Norman-w/SlidingRailHook/output/fit-12mm-v2/delivery/README.md

# 新挂钩 + 复用旧挂钩的兼容轨道

本目录只有这两类打印件，**不包含给新挂钩另打一条 12 mm 轨道**。3MF 均为原生已切片项目，X1 Carbon / 0.4 mm / PETG，未发送打印任务。

## 正式文件

| 文件 | 用途 | 切片估算（含支撑） |
| --- | --- | --- |
| `hook-H12x6-v2-12pcs-PETG-X1C-0p4-0p12.3mf` | 一板 12 个新挂钩，槽净高 12.6 mm，配你现有轨道 | 20.2 g，2 小时 53 分 38 秒；支撑约 2.86 g |
| `legacy-8mm-rail-300-PETG-X1C-0p4-0p20.3mf` | 300 mm 兼容轨道，用来复用之前打印的旧挂钩 | 11.49 g，58 分 31 秒；支撑约 2.61 g |

## 建议先打印试配件

- `hook-H12x6-v2-1pcs-PETG-X1C-0p4-0p12.3mf`：一个新挂钩，试你现有轨道；约 1.99 g / 30 分 25 秒。
- `legacy-8mm-rail-50-PETG-X1C-0p4-0p20.3mf`：50 mm 兼容短轨，试旧挂钩；约 2.22 g / 20 分 54 秒。

确认能从端部装入、往复滑动且不脱轨，再打印正式整板/长轨。STL 也已提供，单位 mm，导入保持 100% 比例。

## 两组尺寸

| 尺寸 | 你现有轨道 / 新挂钩 | 旧挂钩用的兼容轨道 |
| --- | --- | --- |
| 靠墙翼缘高 | 12 mm | 12 mm |
| 靠人翼缘高 | 12 mm | 8 mm |
| 外宽 / 两翼内距 | 6 / 4 mm | 5.8 / 3.8 mm |
| 翼缘 / 腹板厚 | 1 / 1 mm | 1 / 1 mm |
| 挂钩槽净高 | 新版 12.6 mm | 旧版 8.6 mm |

旧挂钩原本只容纳 8 mm 前翼缘，不能装到现有 12 mm 前翼缘上。兼容轨道单独恢复这套尺寸，因此旧挂钩可继续使用。新挂钩只调整滑块配合包络，保留原钩身、R5/240°弯曲和根部圆角，不整体缩放；侧壁保留名义 1 mm。

## 朝向与清理

新挂钩沿用已打印的 v1 PETG 工艺：侧放、0.12 mm 层高、Snug 紧贴普通支撑、3 圈墙、12% Gyroid；没有更改或绕过喷嘴硬度检查。

兼容轨道使用 0.20 mm 层高，绕 X 转 90°侧立，再绕 Z 转 -45°斜放。300 mm 一体轨已通过切片器床面/禁区检查，没有缩放。功能翼缘面竖直打印，悬空窄边下方有实际支撑；清理该窄边、Brim 和毛刺后试装。斜放投影约 216 mm，不表示轨道长度变短。

温度沿用通用 PETG：255°C 喷嘴、65°C Textured PEI。请按实际料卷与板型核对。安装仍需可靠固定和端部防滑脱，未做实际承载试验。

## 验证与边界

已核对新槽 12.6 mm、旧槽 8.6 mm，新参考截面外 6 / 内 4 mm、旧兼容截面外 5.8 / 内 3.8 mm；两组配合从端部进入到整段滑动均无数字干涉。旧挂钩装入 12 mm 翼缘的反例有约 26 mm³ 干涉，明确不能混用。新钩身平移后的形状差异体积小于 0.0001 mm³。

3MF 已通过 CLI 独立重开、封闭实体、数量、1:1 比例、床面与切片警告检查；实际支撑/接触层路径（含圆弧）也已抽样核对。未发现支撑接触新挂钩受保护滑槽/正面，或兼容轨道的翼缘 Z 向滑动平面。

本机图形切片器打开项目后，自动化窗口读取失败，**GUI 预览验收未完成**。请在你的 Bambu Studio 重开最终 3MF，核对机器、喷嘴、PETG、板型及预览。实物试配、表面、收缩、安装和承载仍待确认。

`manifest.json` 保存交付文件 SHA-256；上级 `fit-validation.json` 和各打印子目录 `plate-validation.json` 保存详细结果。内部 `stl/rail.stl` 是新实测轨道的计算参考，不属于本次打印清单。旧发布包、旧挂钩打印包均未覆盖。
