Norman-w/SlidingRailHook/docs/rail-fit-v2.md

# 实测 H 轨配合修正 v2

用户确认的实物截面：两片翼缘均高 12 mm，Z 向外尺寸 6 mm、翼缘内侧净距 4 mm，翼缘及中间腹板厚 1 mm。X 沿轨道、Y 向上、Z 离开柜门；挂钩从 X 端部滑入，C 形开口朝 -Z。材料/工艺沿用 PETG FDM、X1 Carbon 0.4 mm。

原 v1 错把靠人的翼缘设为高 8 mm，滑块 Y 向净空因此只有 8.6 mm，不能安装到 12 mm 高的翼缘上。这是截面理解错误，不是用整体缩放修正的打印收缩。

| 配合项 | 实测轨道 / 新挂钩 v2 | 回收旧挂钩用兼容轨道 |
| --- | --- | --- |
| 靠墙翼缘高 | 12 mm | 12 mm |
| 靠人翼缘高 | 12 mm | 8 mm |
| 外尺寸 / 两翼内距 | 6 / 4 mm | 5.8 / 3.8 mm |
| 翼缘 / 腹板厚 | 1 / 1 mm | 1 / 1 mm |
| 挂钩滑槽 Y 净高 | 12.6 mm | 旧挂钩为 8.6 mm |
| 单侧名义 Y 间隙 | 0.3 mm | 0.3 mm |

新挂钩保持 X 向 18 mm、钩身 9→4.5 mm 锥度、厚 3 mm、R5/240°弯曲及原根部补胶；只按新配合包络派生滑块与钩根位置。滑块侧壁按 1 mm 保留，不挤占 12.6 mm 净空。受力路径仍为钩身 → 连续根部/圆角 → 滑块上下捕获边 → 轨道前翼缘 → 腹板 → 柜门安装面。

`src/rail_legacy_8mm.scad` 是为旧挂钩单独生成的新兼容轨道入口；原 v0.1.0 发布包和 print-12-v1 不覆盖。兼容轨道的 5.8/3.8 mm 为新导出精确尺寸，CSG 重叠只位于腹板端部，不增厚翼缘。

建议先用短轨和一个挂钩试配，确认能从端部装入、往复滑动且不脱轨，再打印长轨/整板。几何无干涉不代表实物首层、装配及长期承载已验收。
