Norman-w/SlidingRailHook/docs/releases/v0.1.0.md

# v0.1.0 — 根部四角连续补胶（FDM 原型）

- 修复挂钩与滑块交界处四个三面交汇角的缺口；保留四条 R1.25 凹圆角，以连续转角曲面连接。
- 保留 R5、240°、12 mm 直段、3 mm 厚度和 9/4.5 mm 渐缩宽度；弯钩仍朝 +Z 人侧。
- 提供一体式 `slider_hook.stl`，不再把重叠的滑块和钩子作为两个可单独装配的打印件。
- 四个打印 STL 均通过封闭拓扑、法线、单一实体和无退化三角面检查。四角分别验证与基座、钩子及相邻胶脚的正体积重叠；轨道 6 个位置的干涉体积均为 0。
- 附带 OpenSCAD 源码、可复现导出/验证脚本、带 XYZ 轴的等轴图、根部近景及 SHA-256 校验和。

下载 `SlidingRailHook-v0.1.0.zip` 获取源码与当前打印件，或分别下载四个 STL。

单位为 mm。轨道长 300 mm、截面高 12 mm、总深 5.8 mm；请先确认打印床尺寸。

**尚未验证：** 指定打印机/材料的切片、0.30 mm 间隙的实物试配、固定方式和承载寿命。此发布为原型，不包含打印任务或额定承载保证。
