Norman-w/SlidingRailHook/output/legacy-rail-upright-v3/delivery/README.md

# 旧挂钩兼容轨道 · 端面朝下竖打 v3 · STL

仅供已经打印的旧版 8.6 mm 槽挂钩复用。不是给新 12.6 mm 槽挂钩另造轨道。
截面与 v2 兼容轨道完全相同：靠墙翼缘高 12 mm、靠人翼缘高 8 mm、总厚 5.8 mm、内距 3.8 mm，翼缘与腹板均厚 1 mm。不做特殊拼接。

- `legacy-hooks-rail-front8-back12-L200-upright-v3.stl`：200 mm 常用版。
- `legacy-hooks-rail-front8-back12-L240-upright-v3.stl`：240 mm 加长版。

## 如何摆放

STL 已将长度转到打印机 Z 轴；以毫米、100% 比例导入，**不要再自动定向或放平**。包围盒应为 **12 × 5.8 × 200/240 mm**；顶视图能看到工字截面。装配坐标 X→打印 Z、装配 Y→打印 X、装配 Z→打印 Y，这是旋转，不是缩放。

本机已安装 X1 Carbon 0.4 mm 配置的 `printable_height` 为 **250 mm**。这两个版本分别留 50/10 mm 高度余量；不把 300 mm 长轨竖着放进去。

## 底部“加固圈”与支撑

竖打每层截面相同，没有需要承托的悬垂。实际 QA 切片保持自动支撑开启，检查 Support 与 Support interface 的挤出路径为零；这不等于细长件已经通过实物防倒测试。

底部在 Bambu Studio 里开启**外侧 Brim，宽 10 mm、物体间距 0.1 mm**，它是单层可拆黏附边，不是主体支撑。STL 本身不保存 Brim、材料、速度或层高。**没有把永久圆盘并入 STL**，否则会挡住挂钩从端部穿入或影响贴墙。拆边并去掉端面毛刺后再装入挂钩。

验证方案沿用 PETG / 0.4 mm，0.20 mm 层高；外墙 25、内墙 35、首层 20 mm/s，常规加速度 500 mm/s²，启用小层冷却减速。先打一条 200 mm，观察首层附着与上端晃动，再决定是否使用 240 mm。不要为了这次导入修改打印机真实喷嘴设置或绕过耗材校验。

没有支撑接触痕不等于镜面：仍有层纹、接缝、收缩或拉丝，先试配，不用整体缩放补偿。把竖向接缝尽量放在贴墙的非滑动面，保留功能面原尺寸。Brim 只能改善底部附着，不能保证消除高处摆动。长轨安装后应沿靠墙翼缘可靠固定，不把薄壁轨当成悬空承重梁。

## 多条安装

长度不够就多打印几条，分别贴装。若需要跨接缝滑动，两条轨道的前翼缘和端面必须对齐、去毛刺；普通端面对接并不是自定位接头，不保证挂钩跨缝完全无感。不要用厚胶堆在滑动面上。

300 mm 在床面内转 45°与向空中倾斜是两回事：前者只改变占地，不会凭空消除 H 型截面的悬垂；后者会产生新的下悬面。这次采用的不是这两种斜放，而是端面着床的竖打。

## 复现与验证边界

源入口：`src/rail_legacy_upright.scad`，参数 `segment_length=200/240`。
执行：`python src/scripts/build_upright_rail.py --slice-check`（依赖 requirements-print.txt、OpenSCAD 与本机 Bambu Studio）。
`manifest.json` 记录源与 STL 哈希、旋转矩阵、尺寸、拓扑、截面和旧挂钩装入路径；`../reports/` 记录本地实际切片检查。内部 QA 的 3MF 不作为本次打印文件交付。未发送打印任务；实物尺寸、层间强度、滑动手感与防倒仍待首件验证。

Brim 的宽度、间距和可移除性说明可核对 [Bambu Studio 官方源代码](https://github.com/bambulab/BambuStudio/blob/v01.10.02.76/src/libslic3r/PrintConfig.cpp)。
