Norman-w/SlidingRailHook/output/fit-12mm-v2/new-hooks-12/toolpaths-review.png

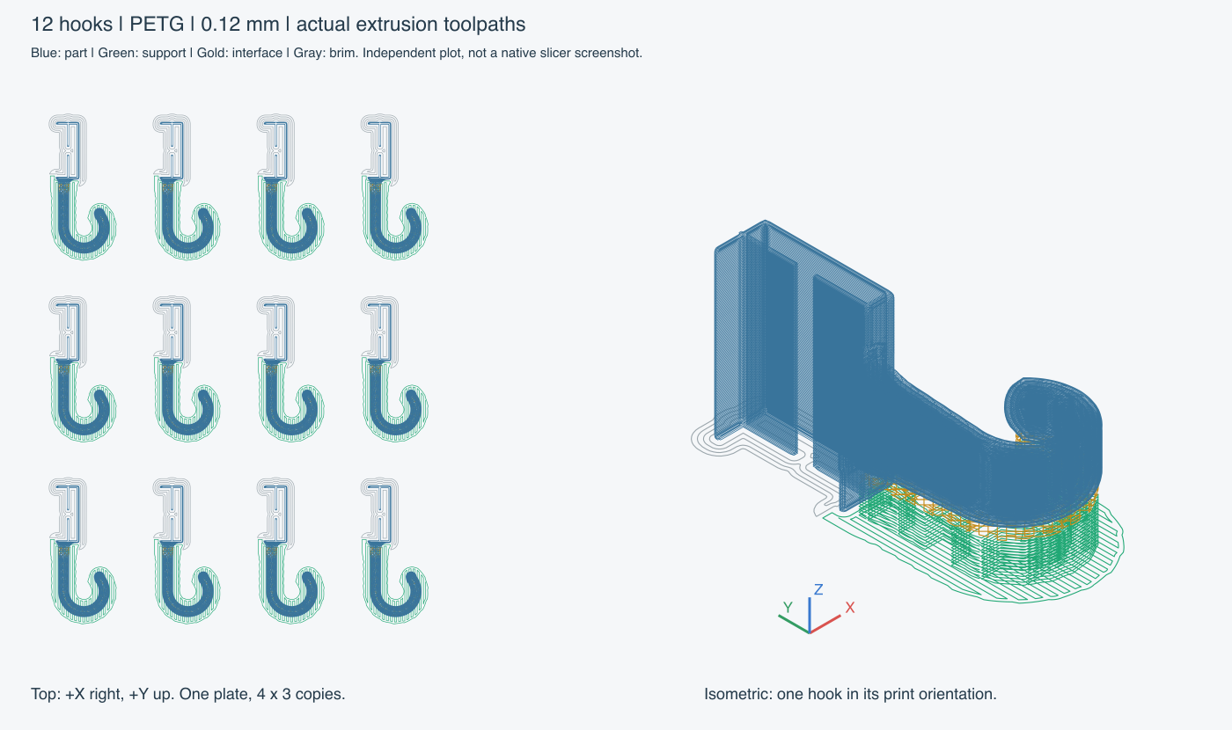
output/fit-12mm-v2/new-hooks-12/toolpaths-review.png
