Norman-w/SlidingRailHook/output/fit-12mm-v2/renders/new-fit-section.png

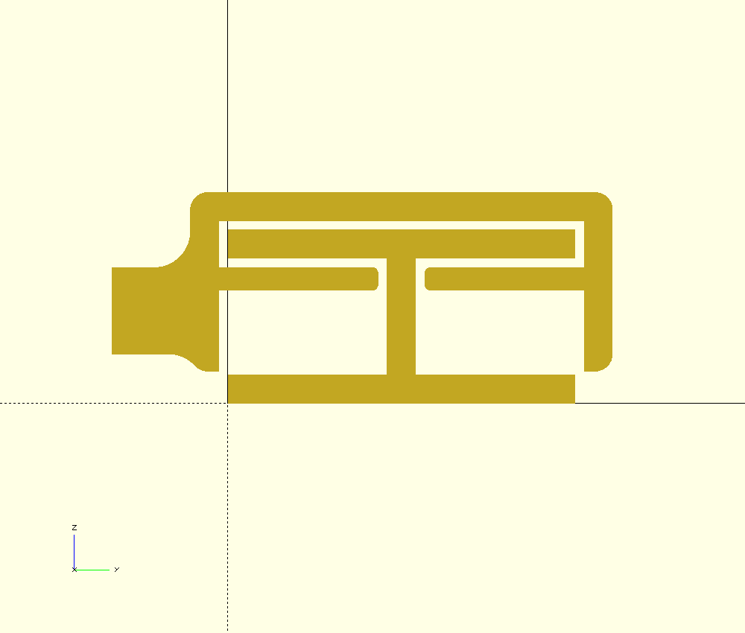
output/fit-12mm-v2/renders/new-fit-section.png
