Norman-w/SlidingRailHook/output/fit-12mm-v2/renders/new-hook-front.png

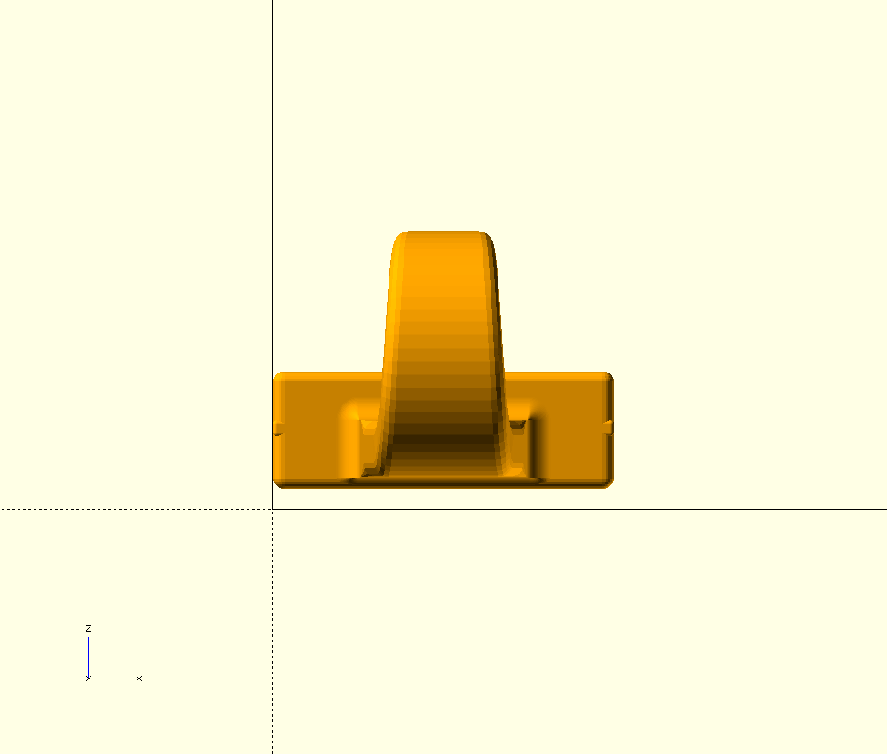
output/fit-12mm-v2/renders/new-hook-front.png
