Norman-w/SlidingRailHook/output/releases/v0.1.0/renders/root-isometric-axes.png

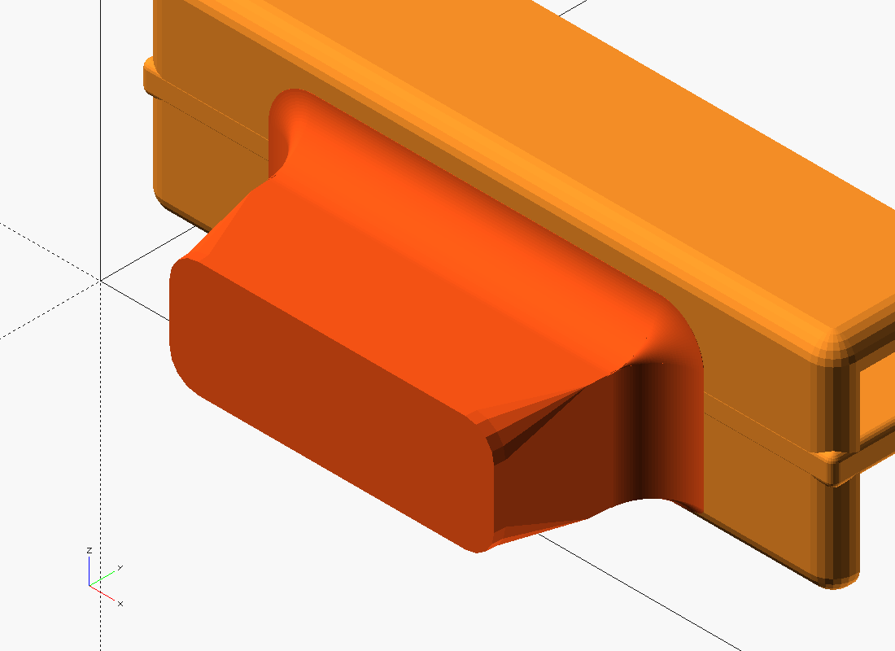
output/releases/v0.1.0/renders/root-isometric-axes.png
