Norman-w/SlidingRailHook/output/releases/v0.1.0/renders/root-underside-axes.png

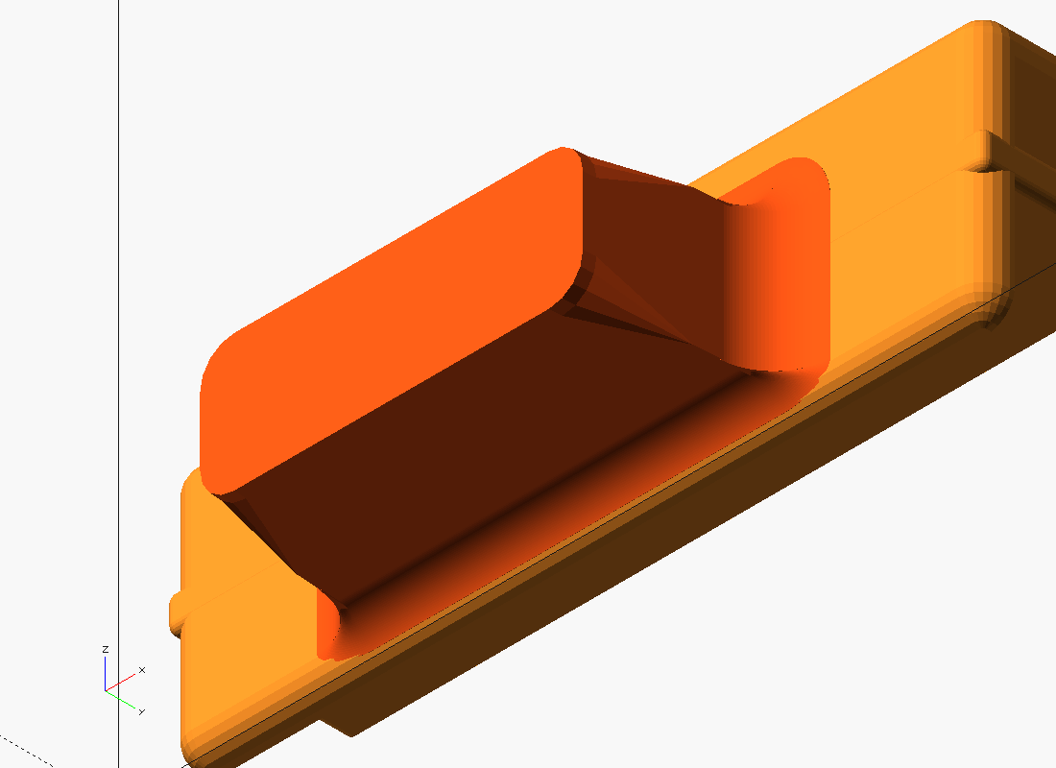
output/releases/v0.1.0/renders/root-underside-axes.png
