Norman-w/SlidingRailHook/output/renders/end-stop-iso.png

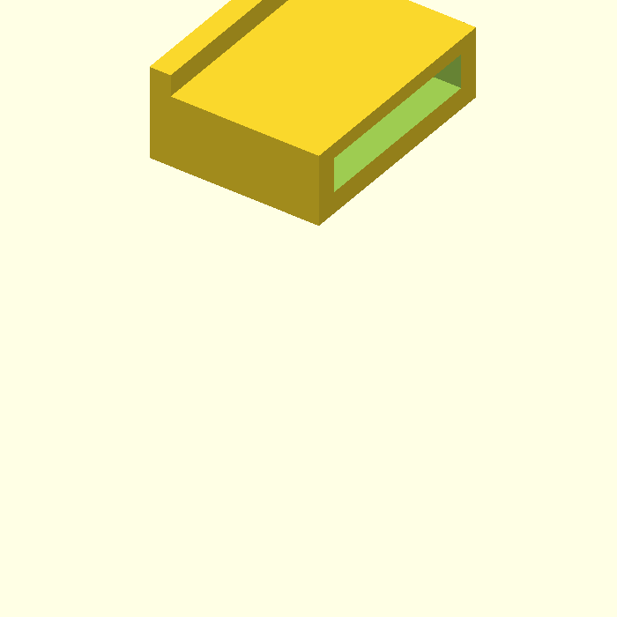
output/renders/end-stop-iso.png
