Norman-w/SlidingRailHook/output/renders/rail-cross-section.png

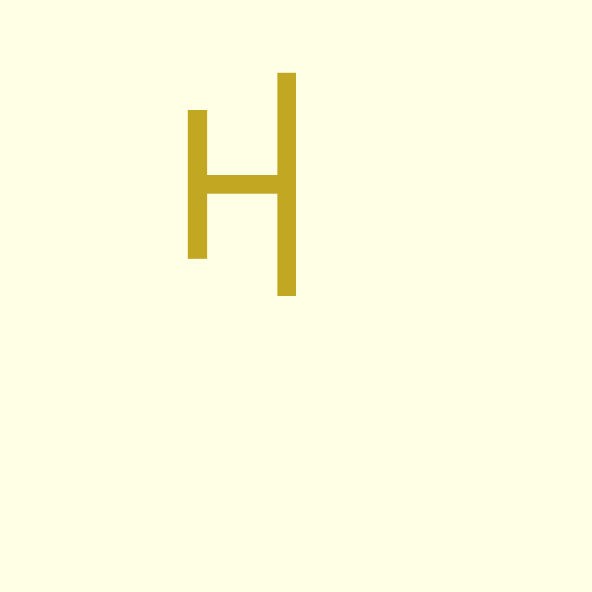
output/renders/rail-cross-section.png
