Norman-w/SlidingRailHook/output/renders/rail-front.png

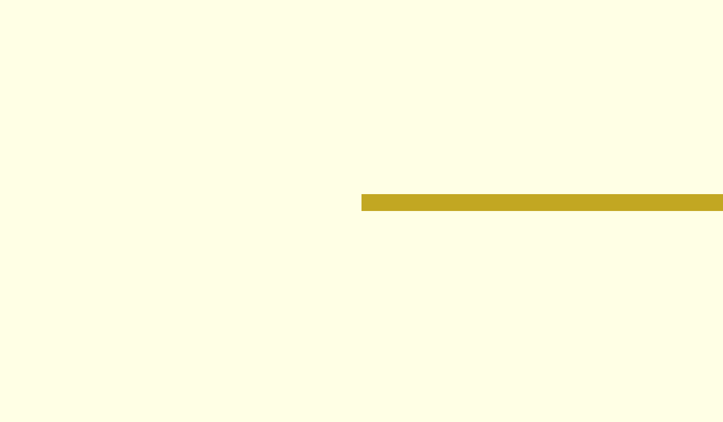
output/renders/rail-front.png
