Norman-w/SlidingRailHook/output/renders/rail-iso.png

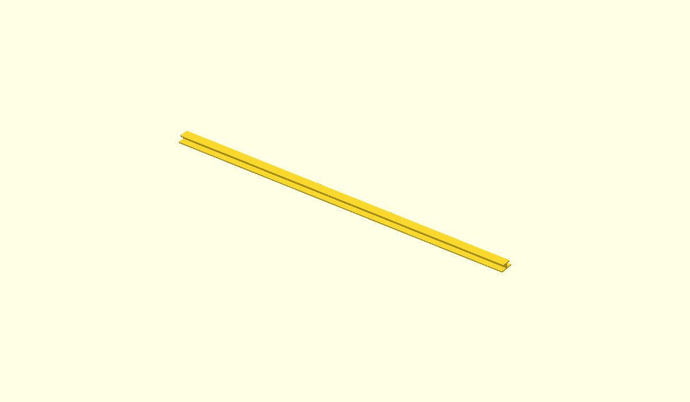
output/renders/rail-iso.png
