Norman-w/SlidingRailHook/output/renders/rail-top.png

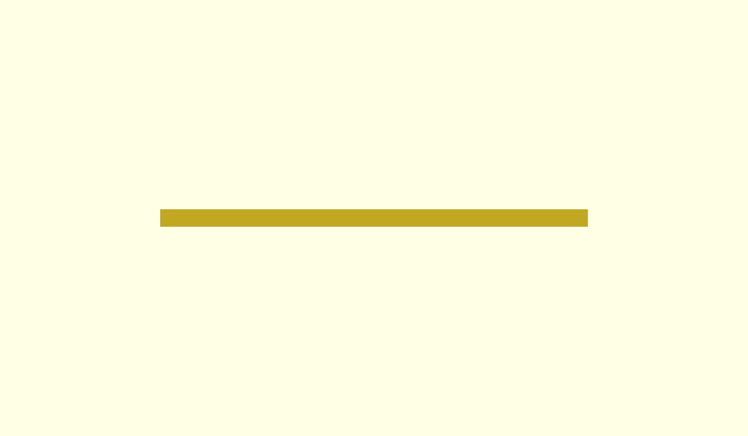
output/renders/rail-top.png
