Norman-w/SlidingRailHook/output/versions/root-side-fillets-v2-2026-10-18/after/renders/root-left-right-plan.png

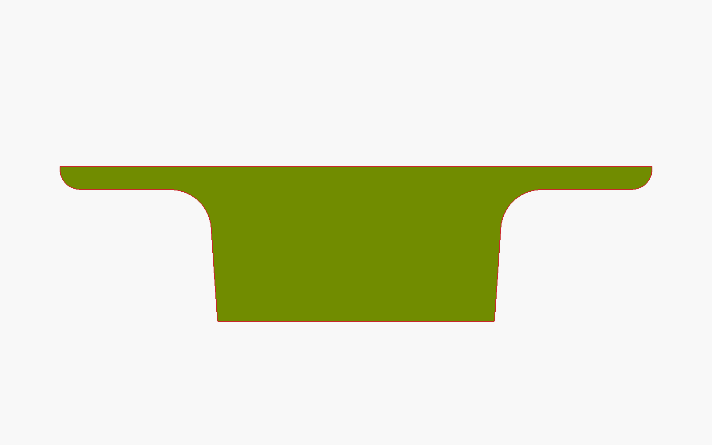
output/versions/root-side-fillets-v2-2026-10-18/after/renders/root-left-right-plan.png
