Norman-w/SlidingRailHook/output/versions/root-side-fillets-v2-2026-10-18/before/renders/hook-bent-side.png

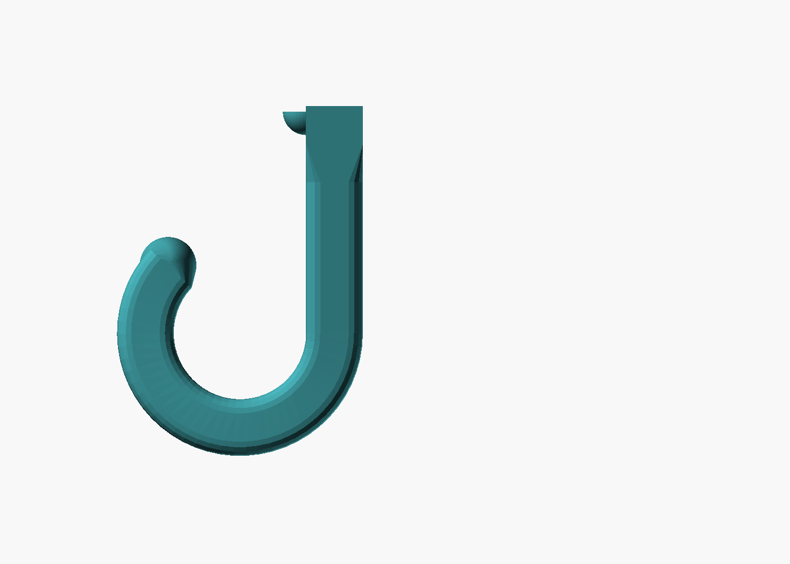
output/versions/root-side-fillets-v2-2026-10-18/before/renders/hook-bent-side.png
