Norman-w/SlidingRailHook/output/versions/root-yz-cove-v3-2026-10-18/after/renders/root-yz-section-axes.png

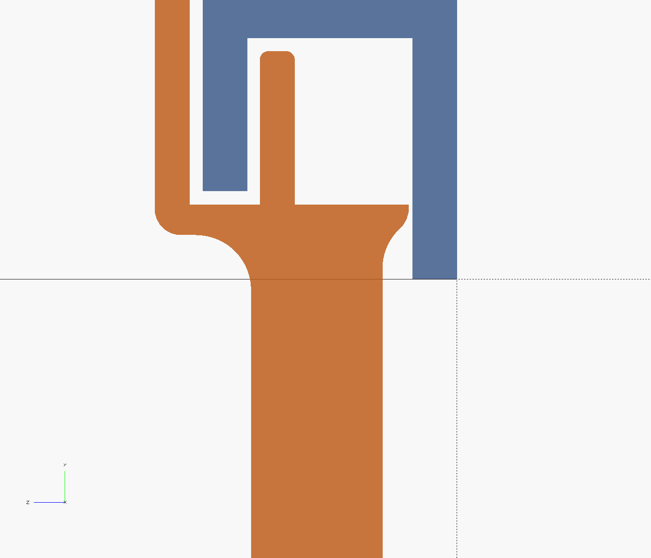
output/versions/root-yz-cove-v3-2026-10-18/after/renders/root-yz-section-axes.png
