Norman-w/SlidingRailHook/output/3d-print/history/hook_bent-240deg-rounded-0p75-endcap-pre-full-round-2026-10-18.stl

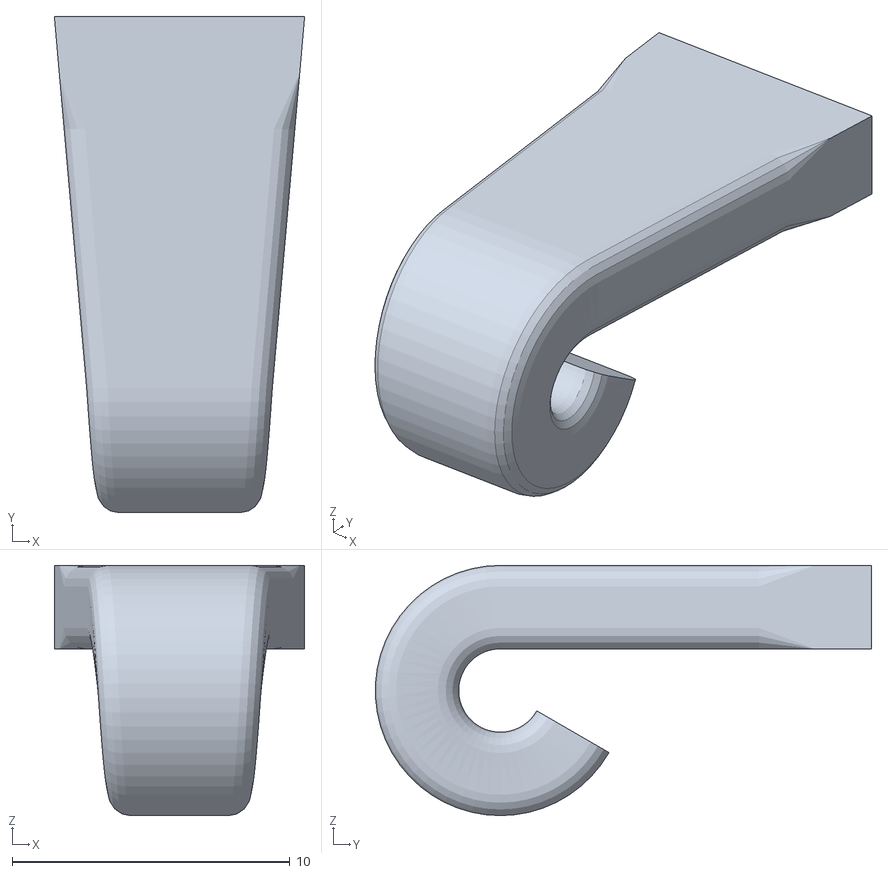
[picture p25: CAD file, 2026-10-18]
output/3d-print/history/hook_bent-240deg-rounded-0p75-endcap-pre-full-round-2026-10-18.stl
9.00 x 17.8 x 9.00
