Norman-w/SlidingRailHook/output/3d-print/history/hook-pre-step-only-2026-10-17.stl

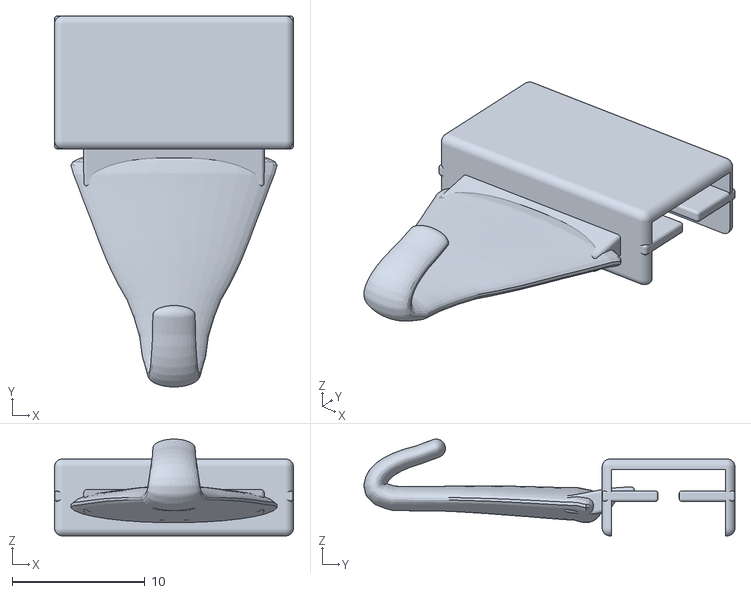
[picture p26: CAD file, 2026-10-18]
output/3d-print/history/hook-pre-step-only-2026-10-17.stl
18.0 x 27.9 x 7.29
