Norman-w/SlidingRailHook/output/3d-print/rail.stl

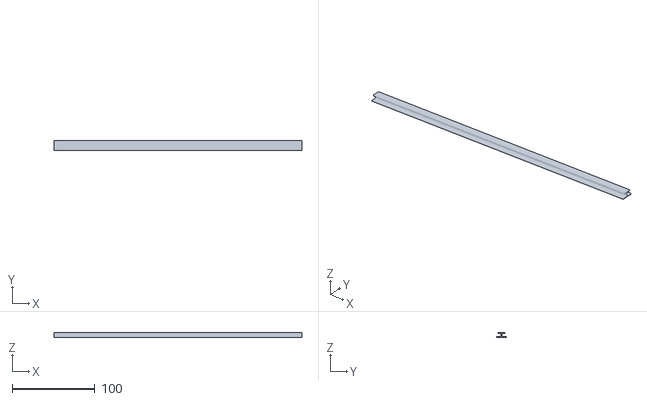
[picture p27: CAD file, 2026-10-18]
output/3d-print/rail.stl
300.0 x 12.0 x 5.80
