Norman-w/SlidingRailHook/output/fit-12mm-v2/delivery/new-hook-H12x6-clear12p6-v2.stl

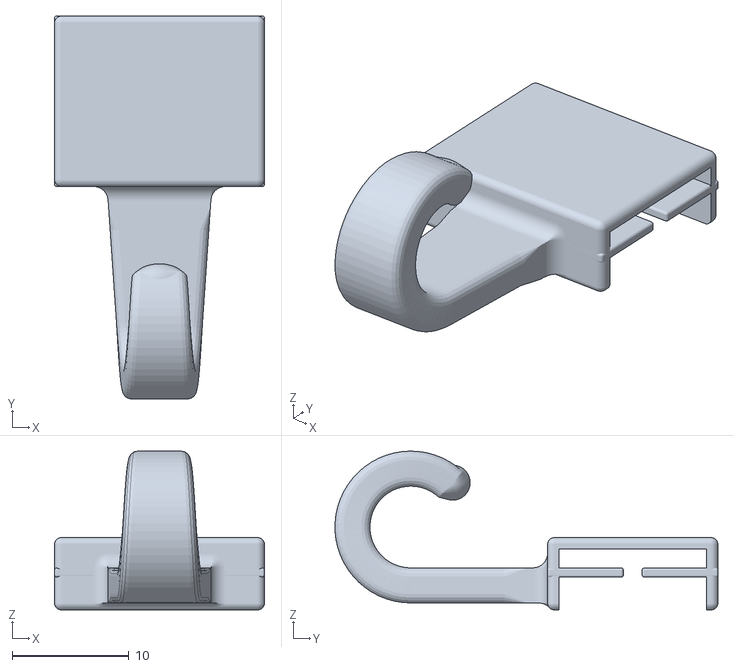
[picture p28: CAD file, 2026-10-20]
output/fit-12mm-v2/delivery/new-hook-H12x6-clear12p6-v2.stl
18.0 x 32.8 x 13.6
