Norman-w/SlidingRailHook/output/fit-12mm-v2/new-hooks-12/hook-H12x6-v2-12pcs-PETG-X1C-0p4-0p12.3mf

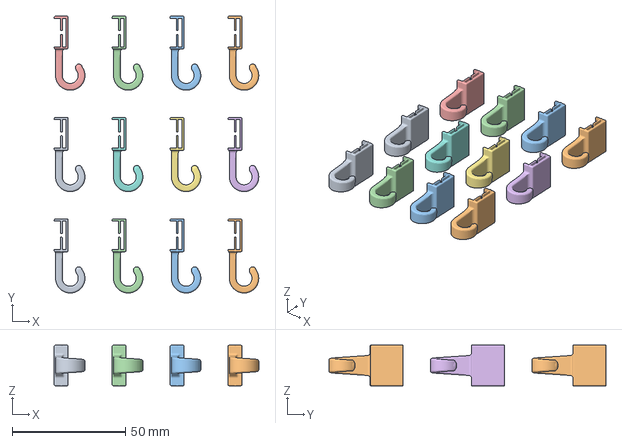
[picture p29: CAD file, 2026-10-20]
output/fit-12mm-v2/new-hooks-12/hook-H12x6-v2-12pcs-PETG-X1C-0p4-0p12.3mf
90.4 x 122.4 x 18.0 mm
SliderHook
hook-12-arranged x 11
