Norman-w/SlidingRailHook/output/fit-12mm-v2/reports/face_-1.stl

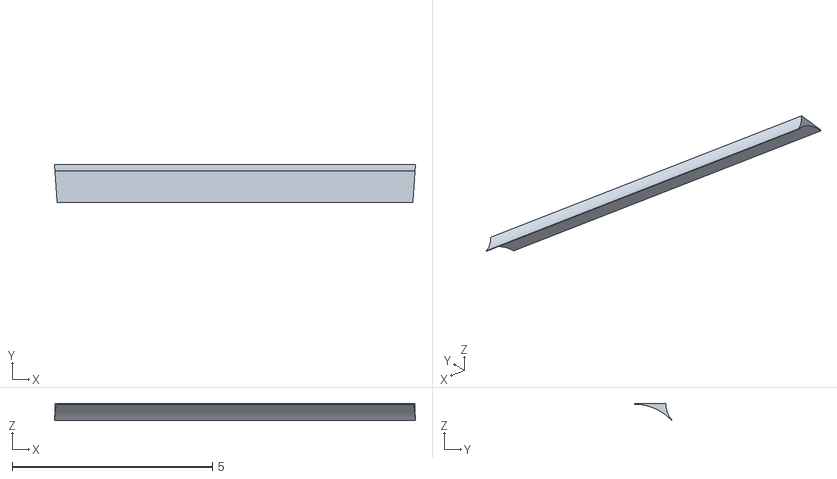
[picture p30: CAD file, 2026-10-20]
output/fit-12mm-v2/reports/face_-1.stl
9.02 x 0.941 x 0.425
