Norman-w/SlidingRailHook/output/fit-12mm-v2/stl/end_stop_left.stl

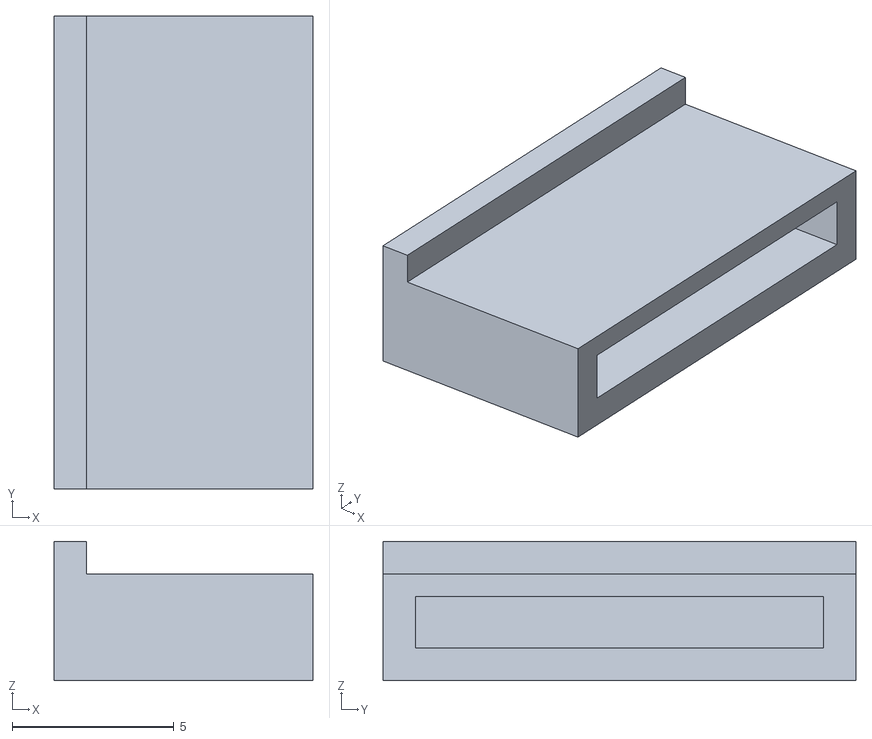
[picture p31: CAD file, 2026-10-20]
output/fit-12mm-v2/stl/end_stop_left.stl
8.00 x 14.6 x 4.30
