Norman-w/SlidingRailHook/output/print-12-v1/hook-12-arranged.3mf

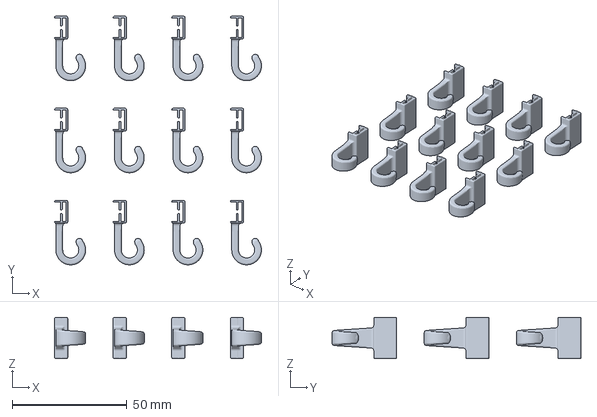
[picture p32: CAD file, 2026-10-18]
output/print-12-v1/hook-12-arranged.3mf
90.4 x 108.6 x 18.0 mm
SliderHook x 12
