Norman-w/SlidingRailHook/output/versions/root-side-fillets-v2-2026-10-18/after/reports/left_hook_overlap.stl

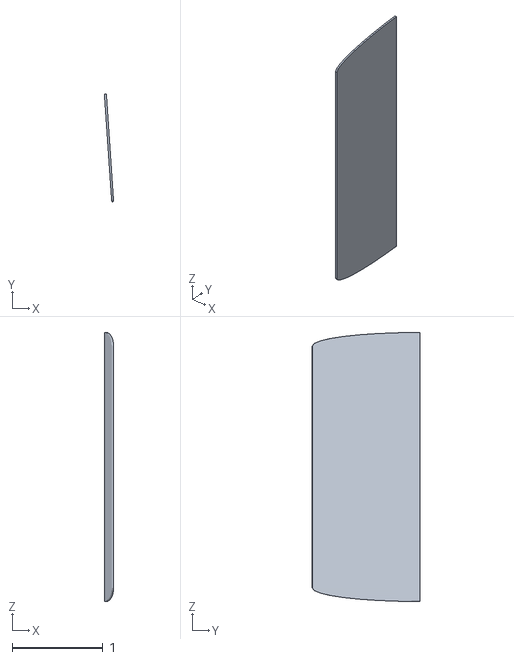
[picture p34: CAD file, 2026-10-18]
output/versions/root-side-fillets-v2-2026-10-18/after/reports/left_hook_overlap.stl
0.102 x 1.18 x 2.96
