Norman-w/SlidingRailHook/output/versions/root-side-fillets-v2-2026-10-18/before/hook_bent.stl

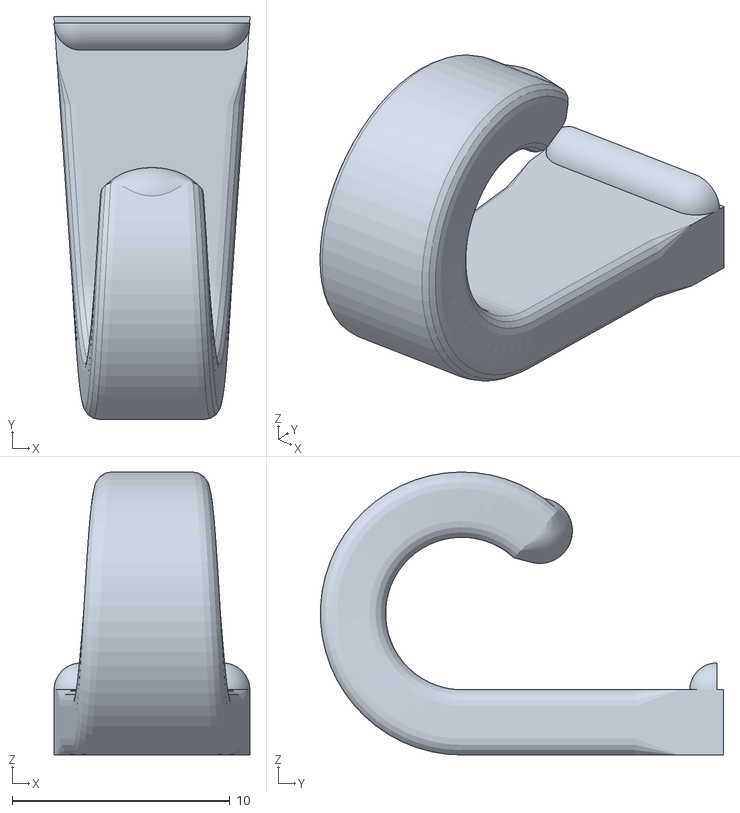
[picture p35: CAD file, 2026-10-18]
output/versions/root-side-fillets-v2-2026-10-18/before/hook_bent.stl
9.00 x 18.5 x 13.0
