Norman-w/SlidingRailHook/output/versions/root-yz-cove-v3-2026-10-18/after/hook_bent.stl

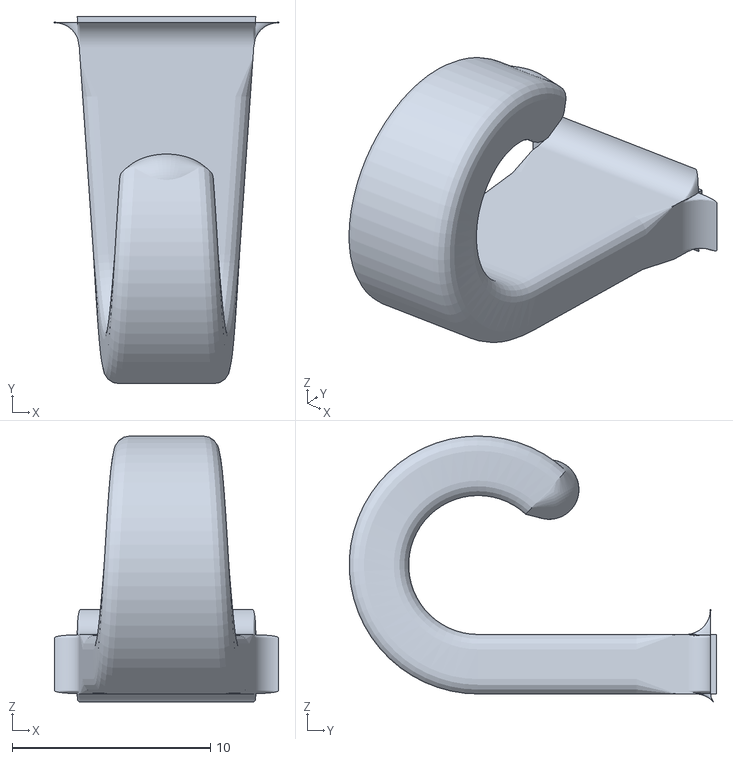
[picture p36: CAD file, 2026-10-18]
output/versions/root-yz-cove-v3-2026-10-18/after/hook_bent.stl
11.3 x 18.5 x 13.4
