Norman-w/SlidingRailHook/output/versions/root-yz-cove-v3-2026-10-18/after/reports/upper_step_overlap.stl

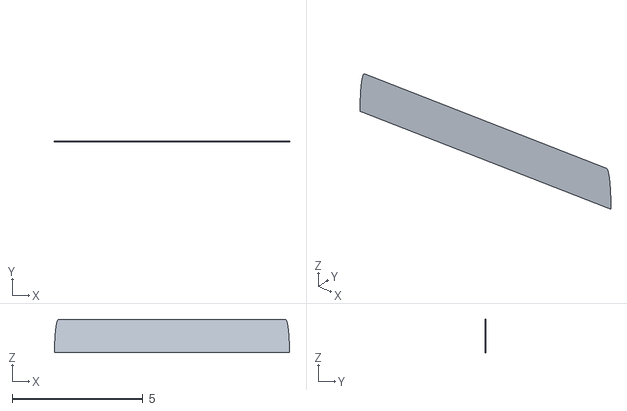
[picture p37: CAD file, 2026-10-18]
output/versions/root-yz-cove-v3-2026-10-18/after/reports/upper_step_overlap.stl
9.00 x 0.0149 x 1.27
