Norman-w/SlidingRailHook/output/fit-12mm-v2/reports/step.stl

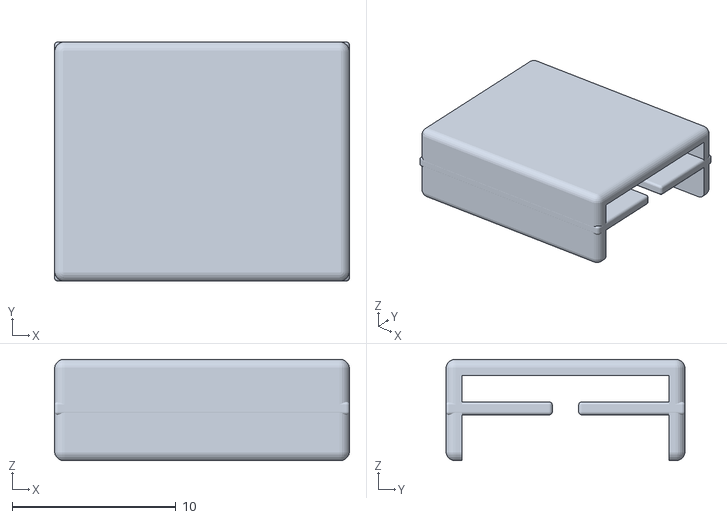
[picture p39: CAD file, 2026-10-20]
output/fit-12mm-v2/reports/step.stl
18.0 x 14.6 x 6.19
