Norman-w/SlidingRailHook/output/versions/root-side-fillets-v2-2026-10-18/after/reports/right_step_overlap.stl

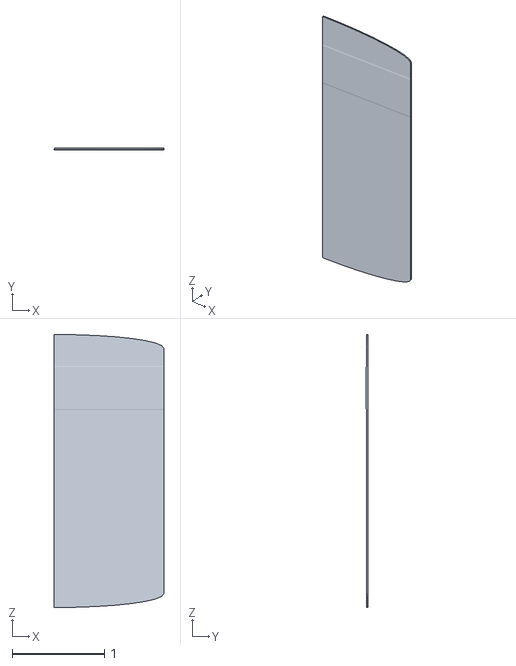
[picture p40: CAD file, 2026-10-18]
output/versions/root-side-fillets-v2-2026-10-18/after/reports/right_step_overlap.stl
1.19 x 0.0183 x 2.96
