Norman-w/SlidingRailHook/output/3d-print/history/hook_bent-240deg-R3-rounded-endcap1p5-pre-R5-2026-10-18.stl

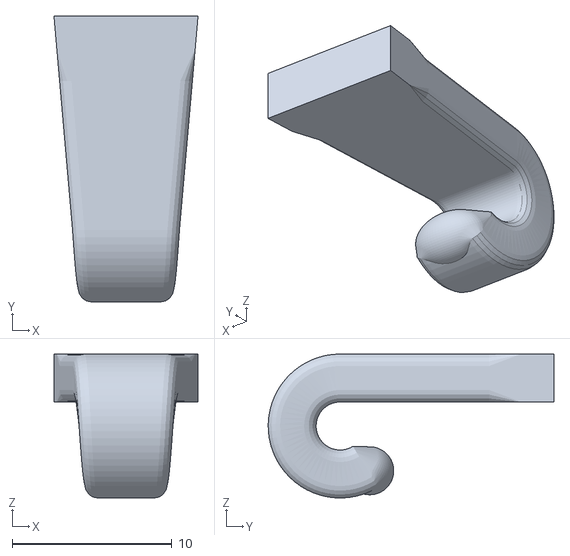
[picture p41: CAD file, 2026-10-18]
output/3d-print/history/hook_bent-240deg-R3-rounded-endcap1p5-pre-R5-2026-10-18.stl
9.00 x 17.9 x 9.00
