Norman-w/SlidingRailHook/output/3d-print/step.stl

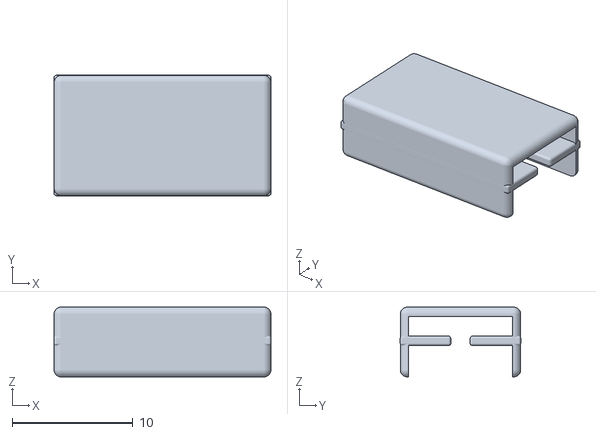
[picture p42: CAD file, 2026-10-18]
output/3d-print/step.stl
18.0 x 10.00 x 5.79
