Norman-w/SlidingRailHook/output/fit-12mm-v2/reports/side_-1.stl

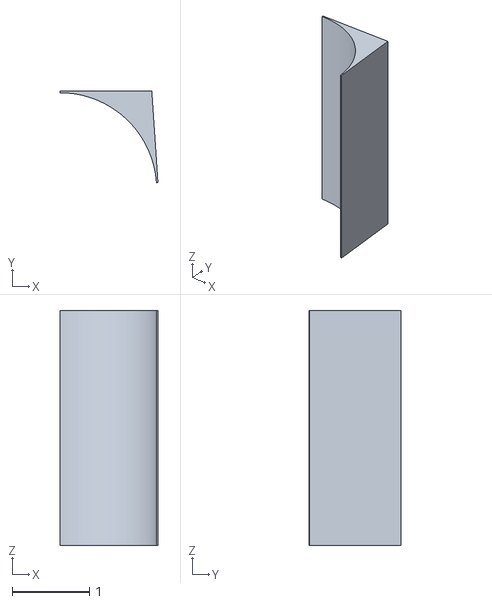
[picture p43: CAD file, 2026-10-20]
output/fit-12mm-v2/reports/side_-1.stl
1.27 x 1.18 x 3.04
