Norman-w/SlidingRailHook/output/3d-print/end_stop_right.stl

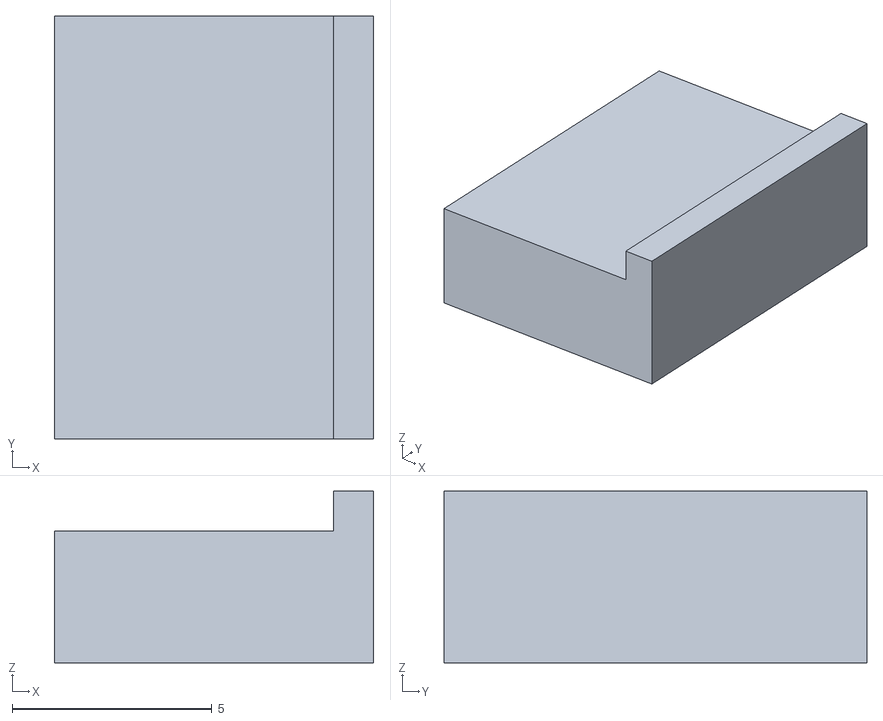
[picture p44: CAD file, 2026-10-18]
output/3d-print/end_stop_right.stl
8.00 x 10.6 x 4.30
