Norman-w/SlidingRailHook/output/fit-12mm-v2/reports/corner_-1_-1.stl

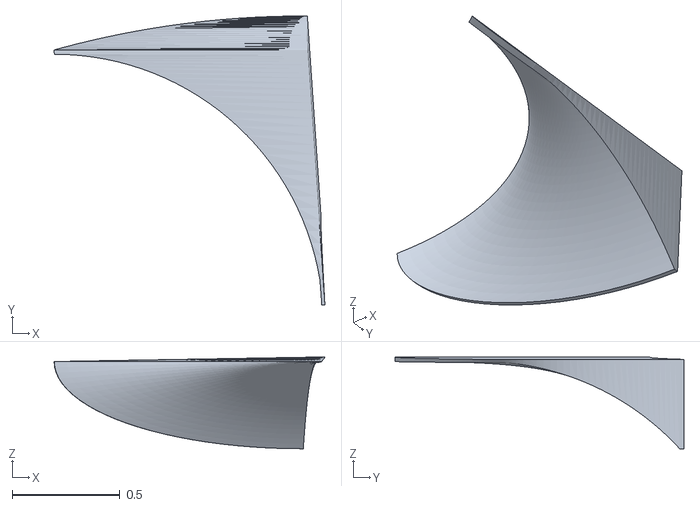
[picture p46: CAD file, 2026-10-20]
output/fit-12mm-v2/reports/corner_-1_-1.stl
1.26 x 1.34 x 0.425
