Norman-w/SlidingRailHook/output/fit-12mm-v2/stl/rail.stl

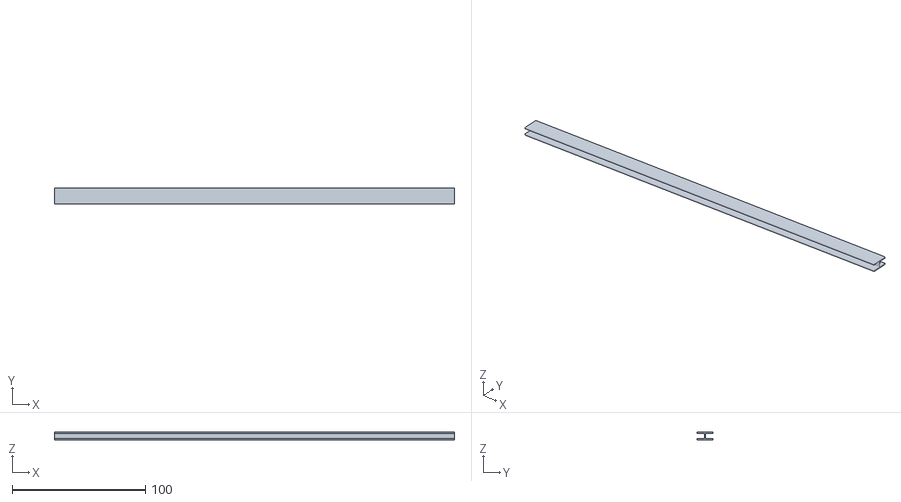
[picture p47: CAD file, 2026-10-20]
output/fit-12mm-v2/stl/rail.stl
300.0 x 12.0 x 6.00
