Norman-w/SlidingRailHook/output/3d-print/history/hook-taper-pre-fairing-2026-10-17.stl

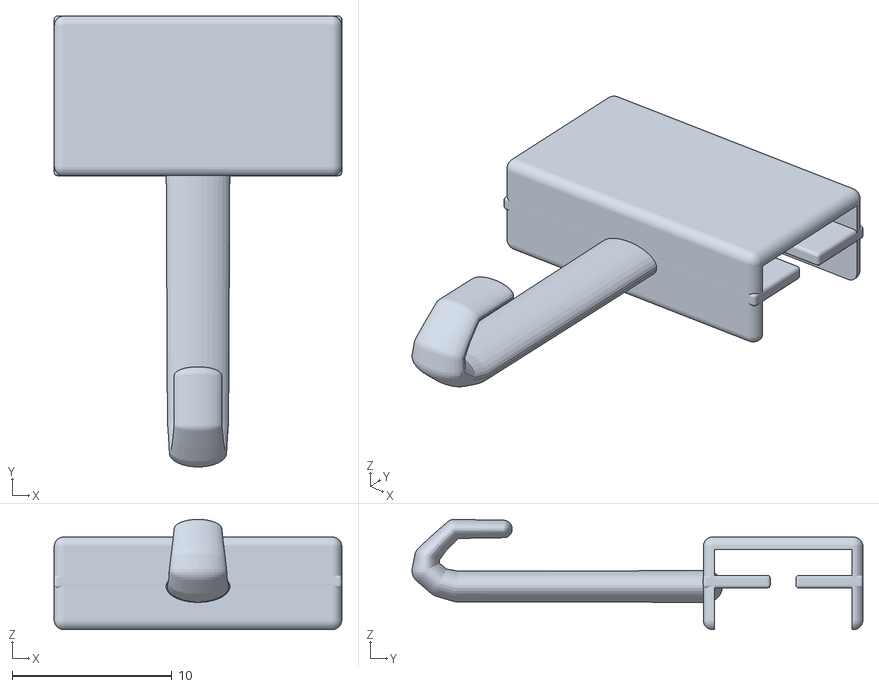
[picture p48: CAD file, 2026-10-18]
output/3d-print/history/hook-taper-pre-fairing-2026-10-17.stl
18.0 x 28.2 x 6.89
