Norman-w/SlidingRailHook/output/fit-12mm-v2/reports/weld.stl

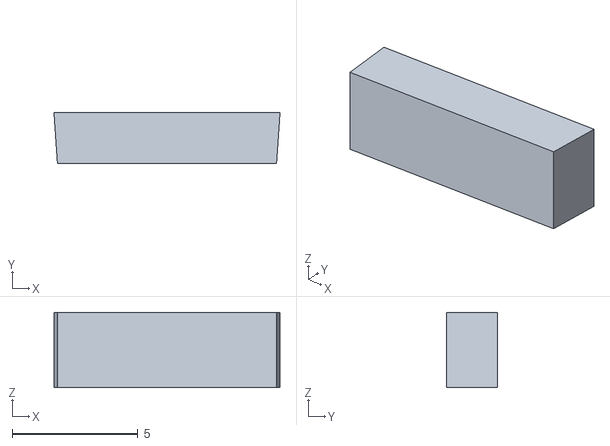
[picture p49: CAD file, 2026-10-20]
output/fit-12mm-v2/reports/weld.stl
9.00 x 2.04 x 3.00
