Norman-w/SlidingRailHook/output/versions/root-side-fillets-v2-2026-10-18/after/reports/joined.stl

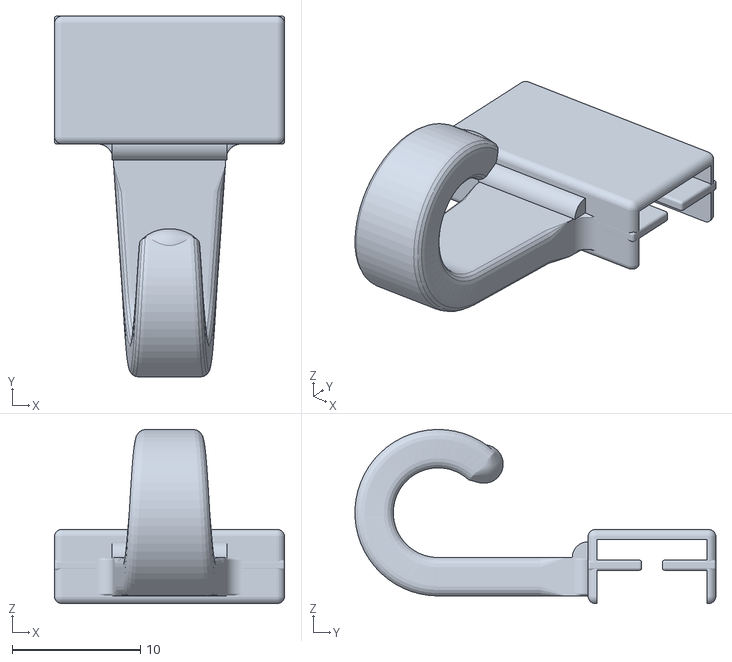
[picture p50: CAD file, 2026-10-18]
output/versions/root-side-fillets-v2-2026-10-18/after/reports/joined.stl
18.0 x 28.2 x 13.6
