Norman-w/SlidingRailHook/output/versions/root-yz-cove-v3-2026-10-18/after/reports/upper_hook_overlap.stl

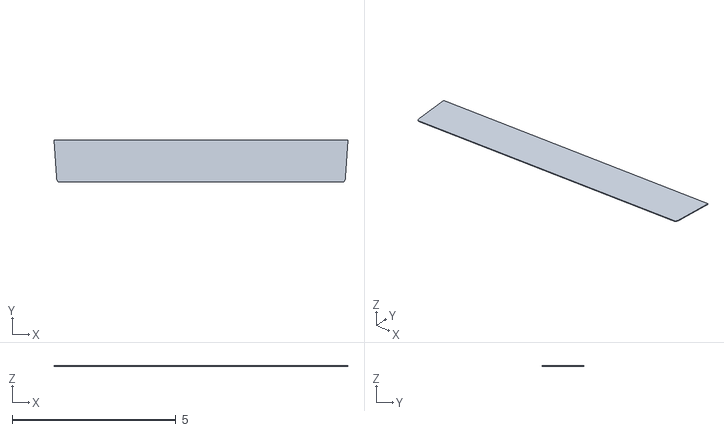
[picture p51: CAD file, 2026-10-18]
output/versions/root-yz-cove-v3-2026-10-18/after/reports/upper_hook_overlap.stl
8.96 x 1.27 x 0.02
