Norman-w/SlidingRailHook/output/3d-print/history/hook-fairing-pre-long-root-2026-10-17.stl

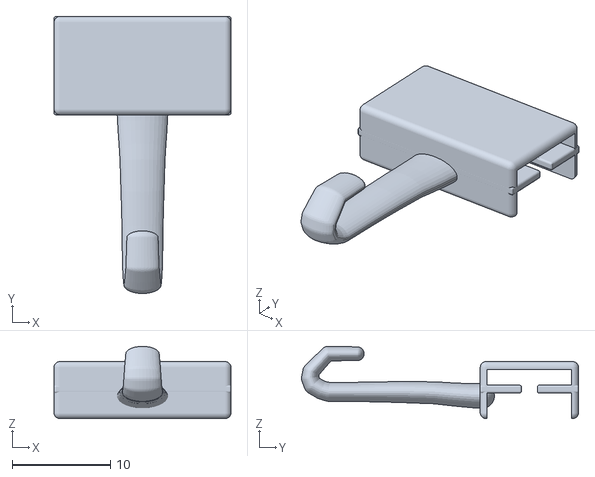
[picture p52: CAD file, 2026-10-18]
output/3d-print/history/hook-fairing-pre-long-root-2026-10-17.stl
18.0 x 28.2 x 7.33
