Norman-w/SlidingRailHook/output/3d-print/history/hook-pre-rounded-2026-10-17.stl

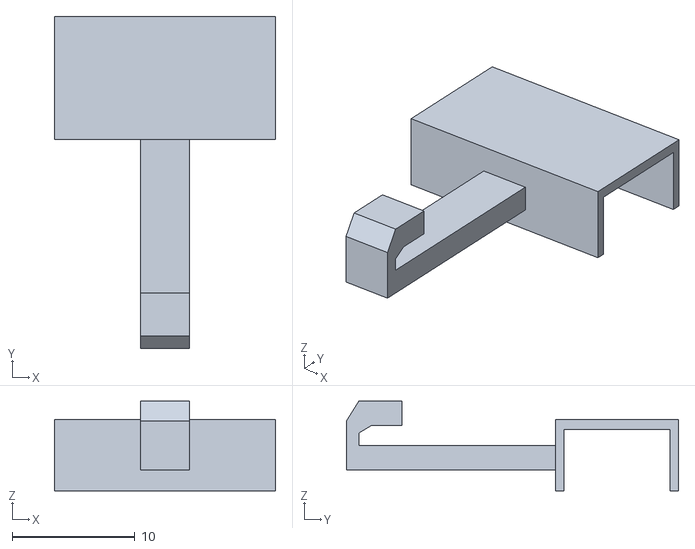
[picture p53: CAD file, 2026-10-18]
output/3d-print/history/hook-pre-rounded-2026-10-17.stl
18.0 x 27.0 x 7.30
