Norman-w/SlidingRailHook/output/versions/root-yz-cove-v3-2026-10-18/after/reports/lower_hook_overlap.stl

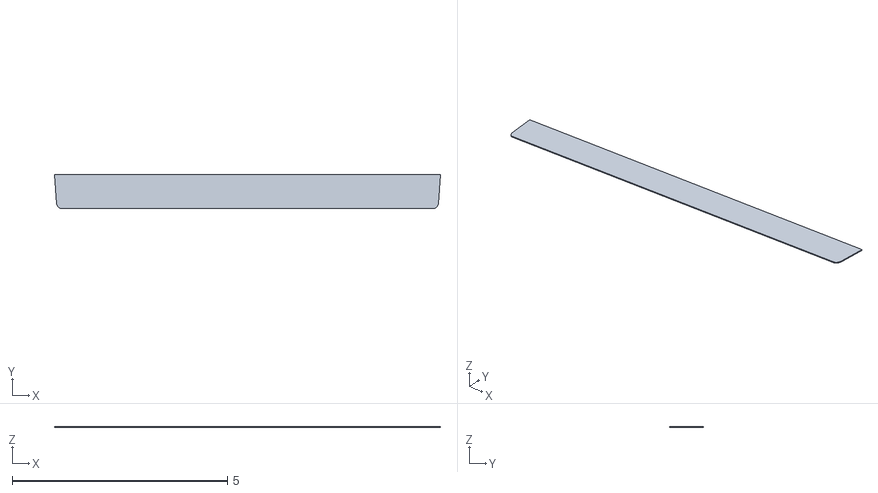
[picture p54: CAD file, 2026-10-18]
output/versions/root-yz-cove-v3-2026-10-18/after/reports/lower_hook_overlap.stl
8.96 x 0.784 x 0.02
