Norman-w/SlidingRailHook/output/3d-print/history/hook_trapezoid-flat-9x20x3-pre-bend-2026-10-18.stl

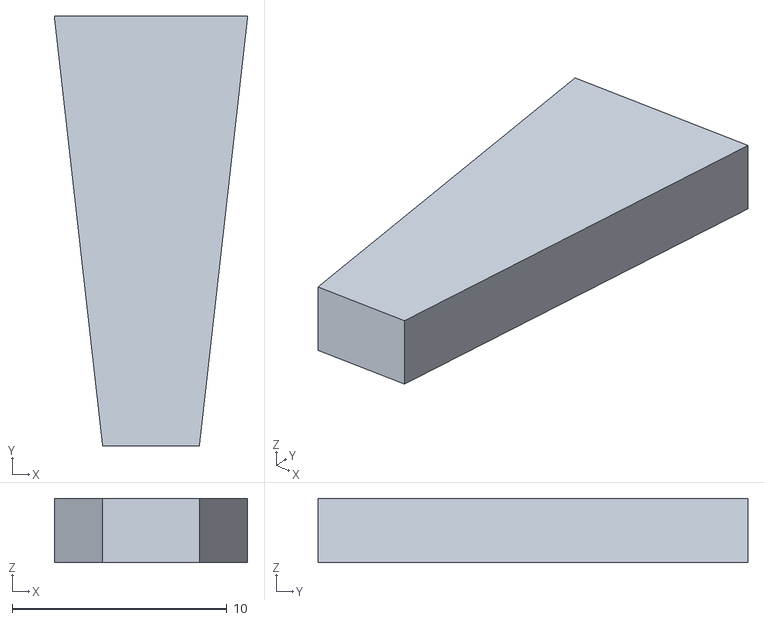
[picture p55: CAD file, 2026-10-18]
output/3d-print/history/hook_trapezoid-flat-9x20x3-pre-bend-2026-10-18.stl
9.00 x 20.0 x 3.00
