Norman-w/SlidingRailHook/output/versions/root-yz-cove-v3-2026-10-18/after/reports/upper_fillet.stl

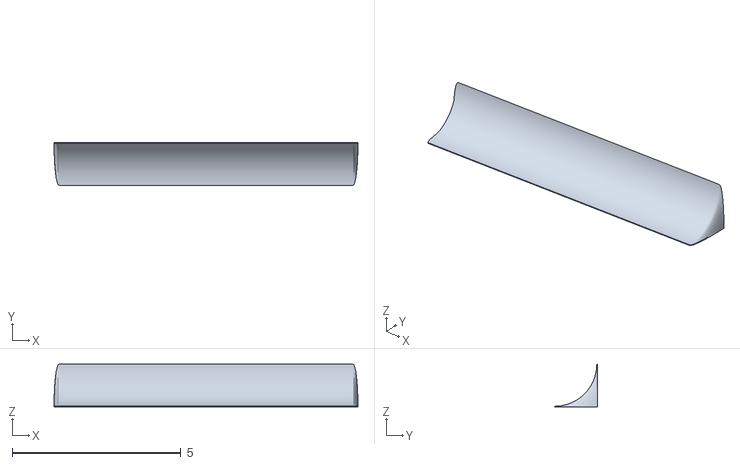
[picture p56: CAD file, 2026-10-18]
output/versions/root-yz-cove-v3-2026-10-18/after/reports/upper_fillet.stl
9.00 x 1.27 x 1.27
