Norman-w/SlidingRailHook/output/3d-print/history/hook_bent-240deg-R5-negative-Z-pre-positive-Z-2026-10-18.stl

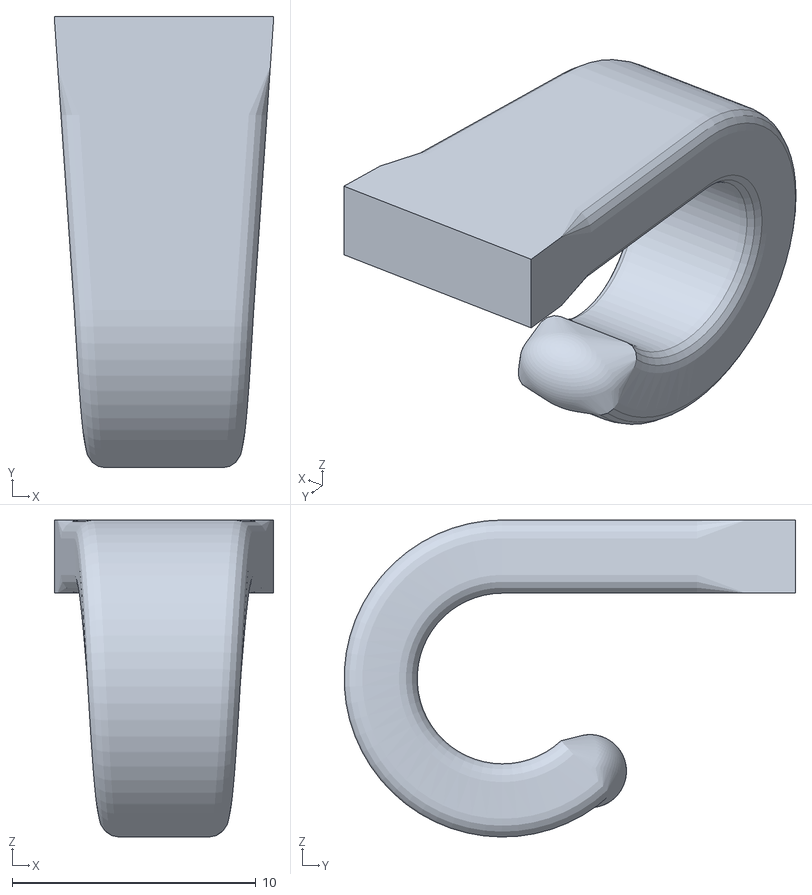
[picture p58: CAD file, 2026-10-18]
output/3d-print/history/hook_bent-240deg-R5-negative-Z-pre-positive-Z-2026-10-18.stl
9.00 x 18.5 x 13.0
