Norman-w/SlidingRailHook/output/3d-print/history/hook-rounded-pre-capture-2026-10-17.stl

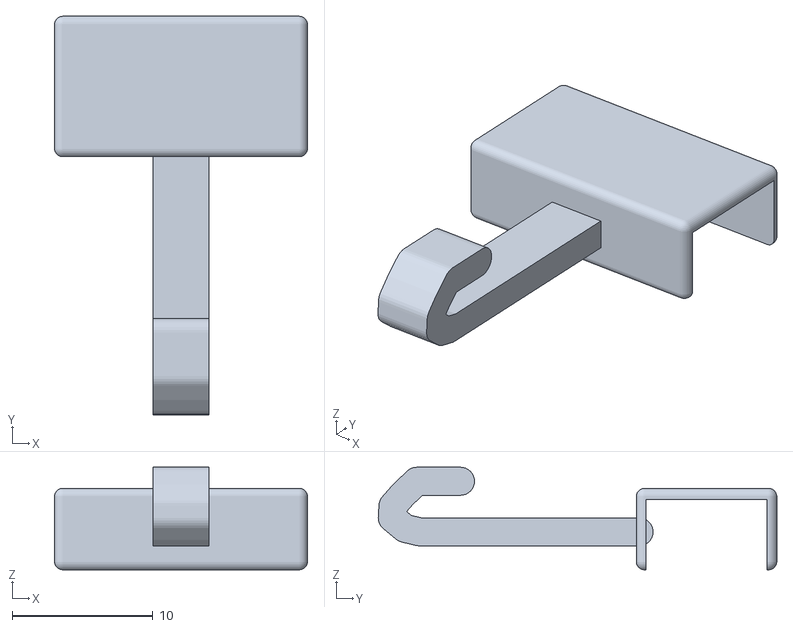
[picture p59: CAD file, 2026-10-18]
output/3d-print/history/hook-rounded-pre-capture-2026-10-17.stl
18.0 x 28.3 x 7.30
