Norman-w/SlidingRailHook/output/3d-print/history/hook_bent-300deg-pre-240deg-2026-10-18.stl

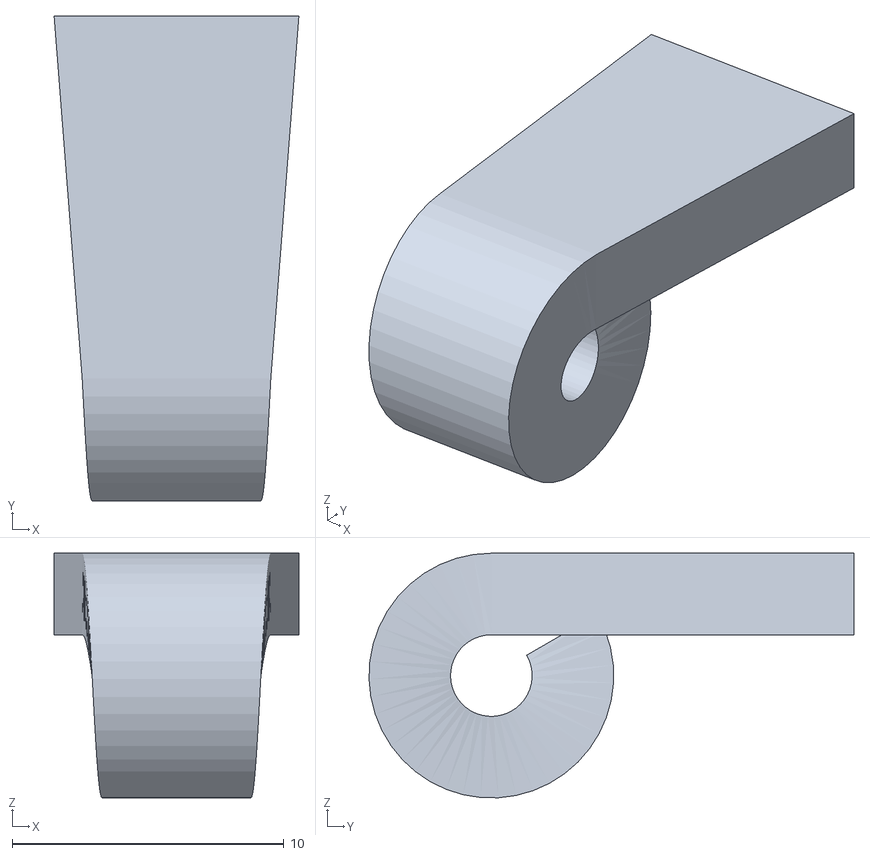
[picture p60: CAD file, 2026-10-18]
output/3d-print/history/hook_bent-300deg-pre-240deg-2026-10-18.stl
9.00 x 17.8 x 8.99
