Norman-w/SlidingRailHook/(list of files, cad)

Other CAD files:
output/fit-12mm-v2/new-hook-test-1/hook-H12x6-v2-1pcs-PETG-X1C-0p4-0p12.3mf
output/fit-12mm-v2/new-hook-test-1/hook-1-arranged.3mf
output/fit-12mm-v2/new-hooks-12/hook-12-arranged.3mf
output/fit-12mm-v2/stl/end_stop_right.stl
output/print-12-v1/hook-12-PETG-X1C-0p4-0p12.3mf
output/versions/root-yz-cove-v3-2026-10-18/after/reports/lower_fillet.stl
output/versions/root-side-fillets-v2-2026-10-18/after/reports/left_step_overlap.stl
output/versions/root-yz-cove-v3-2026-10-18/after/reports/right_hook_overlap.stl
output/versions/root-side-fillets-v2-2026-10-18/after/reports/hook-cgal.stl
output/3d-print/end_stop_left.stl
output/fit-12mm-v2/delivery/hook-H12x6-v2-1pcs-PETG-X1C-0p4-0p12.3mf
output/versions/root-side-fillets-v2-2026-10-18/after/reports/right_hook_overlap.stl
output/3d-print/history/hook-2d-bridge-pre-root-thicken-2026-10-17.stl
output/versions/root-yz-cove-v3-2026-10-18/after/reports/hook-cgal.stl
output/3d-print/history/hook-root-shoulder-pre-overlap-2026-10-17.stl
output/versions/root-yz-cove-v3-2026-10-18/after/reports/left_step_overlap.stl
output/3d-print/history/hook-anchor-pre-2d-bridge-2026-10-17.stl
output/versions/root-yz-cove-v3-2026-10-18/after/reports/joined.stl
output/3d-print/history/hook_bent-240deg-R5-positive-Z-pre-bond-fillet-2026-10-18.stl
output/versions/root-side-fillets-v2-2026-10-18/after/src/parameters.scad
output/versions/root-side-fillets-v2-2026-10-18/before/src/parameters.scad
output/versions/root-yz-cove-v3-2026-10-18/after/src/parameters.scad
output/versions/root-yz-cove-v3-2026-10-18/before/src/parameters.scad
output/versions/root-side-fillets-v2-2026-10-18/after/src/hook_bent.scad
output/versions/root-side-fillets-v2-2026-10-18/after/src/rail.scad
output/versions/root-side-fillets-v2-2026-10-18/after/src/root_joint_check.scad
output/versions/root-side-fillets-v2-2026-10-18/before/src/assembly.scad
output/versions/root-side-fillets-v2-2026-10-18/before/src/hook_bent.scad
output/versions/root-yz-cove-v3-2026-10-18/after/src/hook_bent.scad
output/versions/root-yz-cove-v3-2026-10-18/after/src/rail.scad
output/versions/root-yz-cove-v3-2026-10-18/after/src/root_joint_check.scad
output/versions/root-yz-cove-v3-2026-10-18/before/src/hook_bent.scad
output/versions/root-yz-cove-v3-2026-10-18/before/src/rail.scad
output/versions/root-yz-cove-v3-2026-10-18/before/src/root_joint_check.scad
output/fit-12mm-v2/delivery/legacy-8mm-rail-300-PETG-X1C-0p4-0p20.3mf
output/fit-12mm-v2/delivery/legacy-8mm-rail-50-PETG-X1C-0p4-0p20.3mf
output/fit-12mm-v2/delivery/legacy-hooks-rail-front8-back12-L300-v2.stl
output/fit-12mm-v2/delivery/legacy-hooks-rail-front8-back12-L50-test-v2.stl
output/fit-12mm-v2/legacy-rail-300-print/legacy-8mm-rail-300-PETG-X1C-0p4-0p20.3mf
output/fit-12mm-v2/legacy-rail-50-print/legacy-8mm-rail-50-PETG-X1C-0p4-0p20.3mf
output/fit-12mm-v2/legacy-rail-8mm-front-300.stl
output/fit-12mm-v2/legacy-rail-8mm-front-50.stl
output/fit-12mm-v2/reports/corner_-1_1.stl
output/fit-12mm-v2/reports/corner_1_-1.stl
output/fit-12mm-v2/reports/corner_1_1.stl
output/fit-12mm-v2/reports/face_1.stl
output/fit-12mm-v2/reports/side_1.stl
output/legacy-rail-upright-v3/delivery/legacy-hooks-rail-front8-back12-L200-upright-v3.stl
output/legacy-rail-upright-v3/delivery/legacy-hooks-rail-front8-back12-L240-upright-v3.stl
output/print-12-v1/source/slider_hook.stl
output/releases/v0.1.0/reports/corner_-1_-1.stl
output/releases/v0.1.0/reports/corner_-1_1.stl
output/releases/v0.1.0/reports/corner_1_-1.stl
output/releases/v0.1.0/reports/corner_1_1.stl
output/releases/v0.1.0/reports/face_-1.stl
output/releases/v0.1.0/reports/face_1.stl
output/releases/v0.1.0/reports/side_-1.stl
output/releases/v0.1.0/reports/side_1.stl
output/releases/v0.1.0/reports/step.stl
output/releases/v0.1.0/reports/weld.stl
output/releases/v0.1.0/stl/end_stop_left.stl
output/releases/v0.1.0/stl/end_stop_right.stl
output/releases/v0.1.0/stl/rail.stl
output/releases/v0.1.0/stl/slider_hook.stl
src/rail_legacy_8mm.scad
src/rail_legacy_upright.scad
