Norman-w/SlidingRailHook/requirements-print.txt

-r requirements-qa.txt
scipy==1.18.1
rtree==1.4.1
