Norman-w/SlidingRailHook/output/releases/v0.1.0/renders/assembly-isometric-axes.png

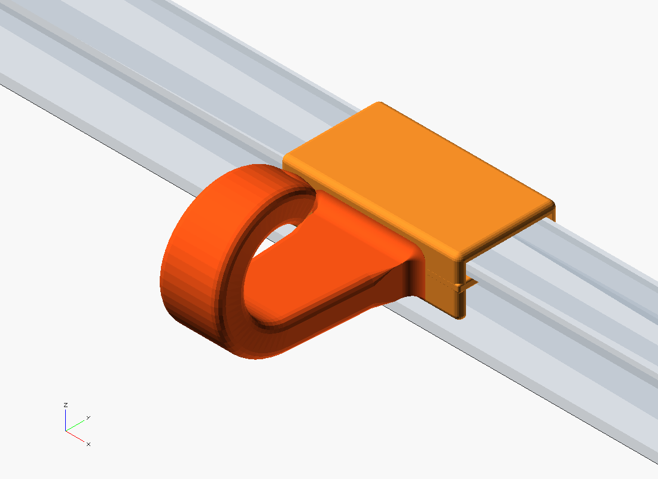
output/releases/v0.1.0/renders/assembly-isometric-axes.png
