Norman-w/SlidingRailHook/output/renders/history-hook-2026-10-17/assembly-capture-section.png

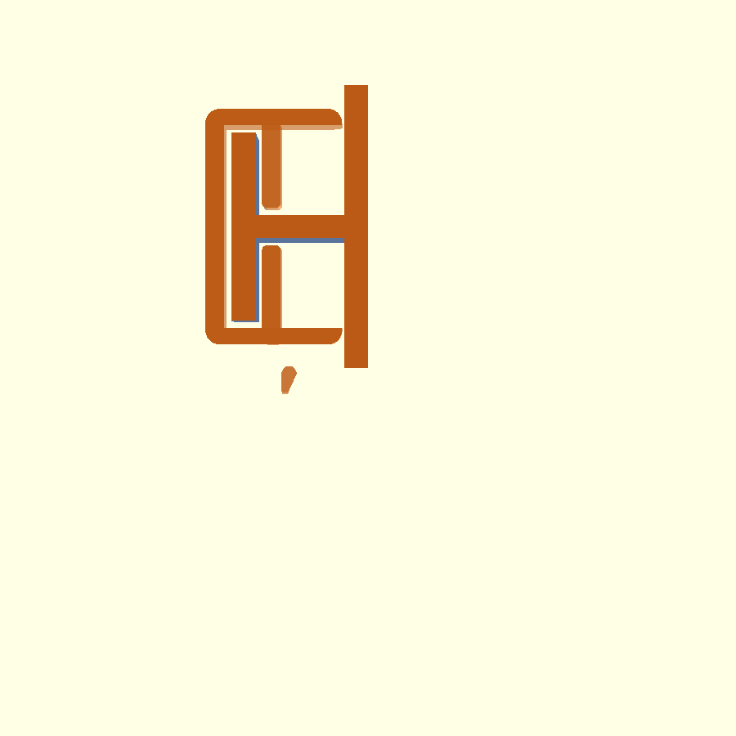
output/renders/history-hook-2026-10-17/assembly-capture-section.png
