Norman-w/SlidingRailHook/output/renders/history-hook-2026-10-17/assembly-cross.png

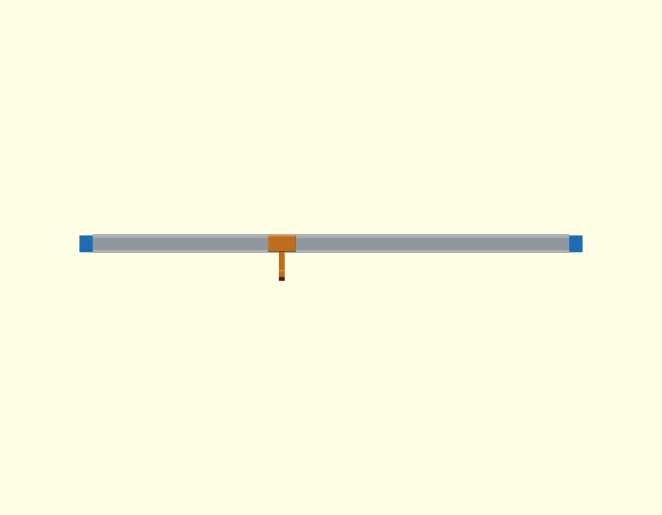
output/renders/history-hook-2026-10-17/assembly-cross.png
