Norman-w/SlidingRailHook/output/renders/history-hook-bent-240deg-R3-rounded-endcap1p5-2026-10-18/rail-step-bent-assembly-iso.png

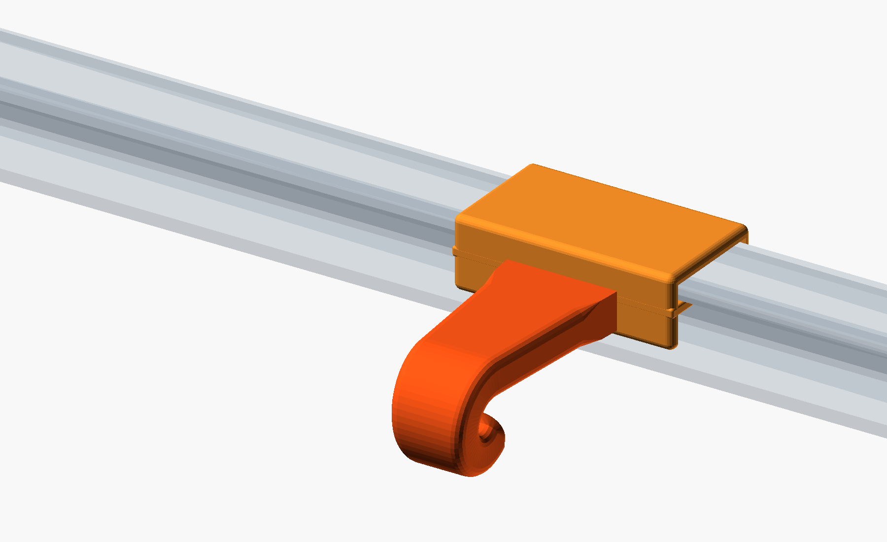
output/renders/history-hook-bent-240deg-R3-rounded-endcap1p5-2026-10-18/rail-step-bent-assembly-iso.png
