Norman-w/SlidingRailHook/output/renders/history-hook-bent-240deg-unrounded-2026-10-18/rail-step-bent-assembly-iso.png

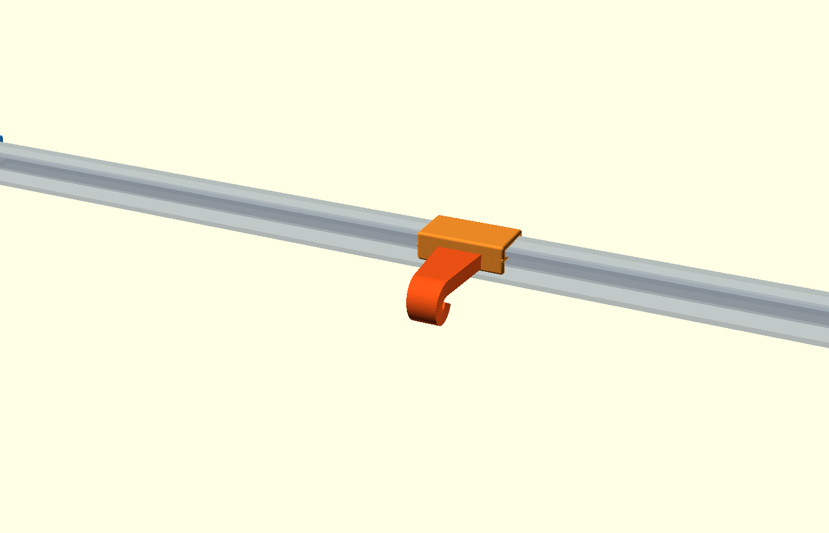
output/renders/history-hook-bent-240deg-unrounded-2026-10-18/rail-step-bent-assembly-iso.png
