Norman-w/SlidingRailHook/output/renders/step-only/assembly-isometric-axes.png

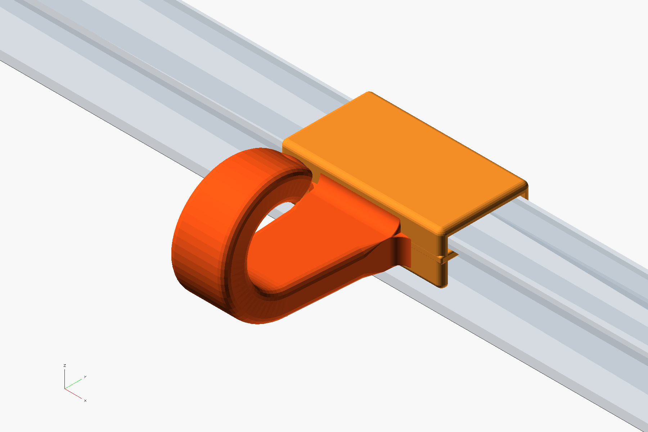
output/renders/step-only/assembly-isometric-axes.png
