Norman-w/SlidingRailHook/output/renders/step-only/rail-step-bent-assembly-iso.png

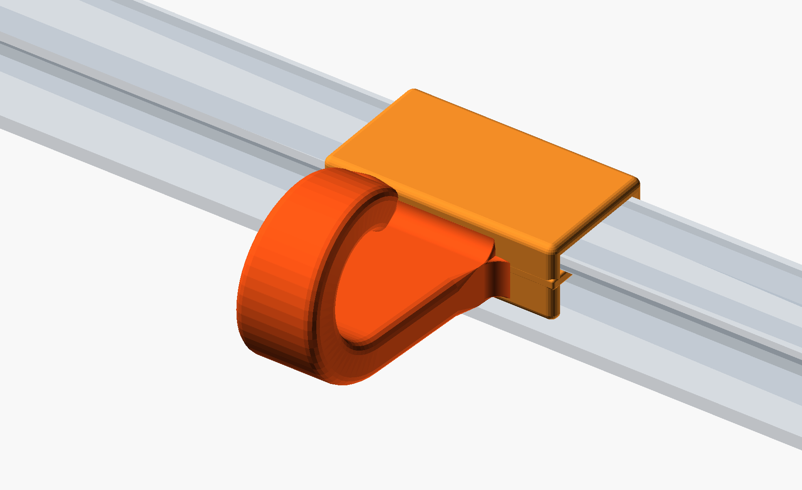
output/renders/step-only/rail-step-bent-assembly-iso.png
