Norman-w/SlidingRailHook/output/renders/step-only/rail-step-bent-h-section.png

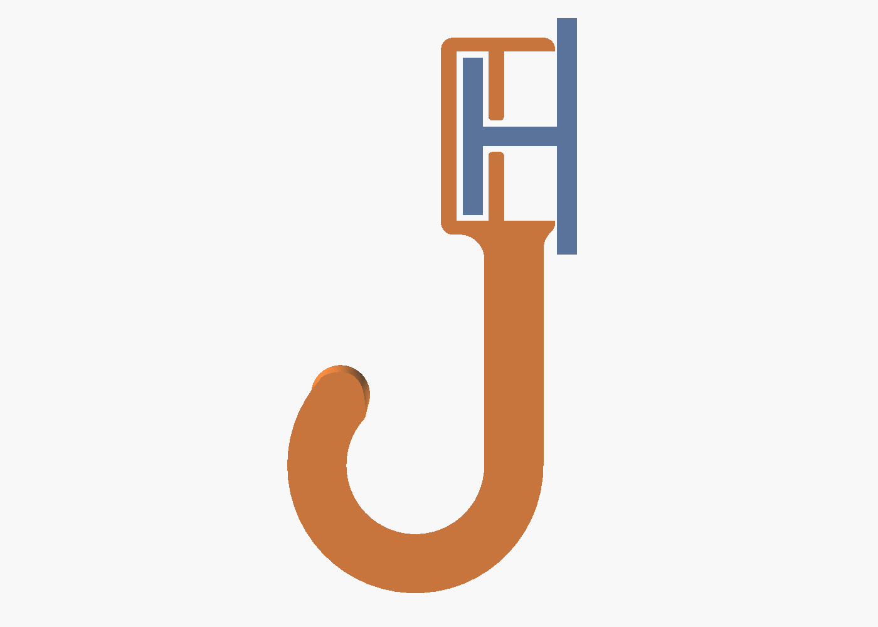
output/renders/step-only/rail-step-bent-h-section.png
