Norman-w/SlidingRailHook/output/renders/step-only/step.png

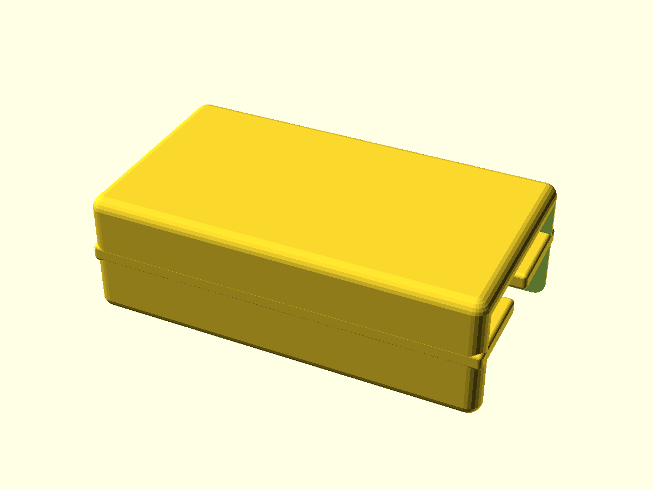
output/renders/step-only/step.png
