Norman-w/SlidingRailHook/output/renders/history-hook-2026-10-17/candidates/fairing-candidate/hook-side.png

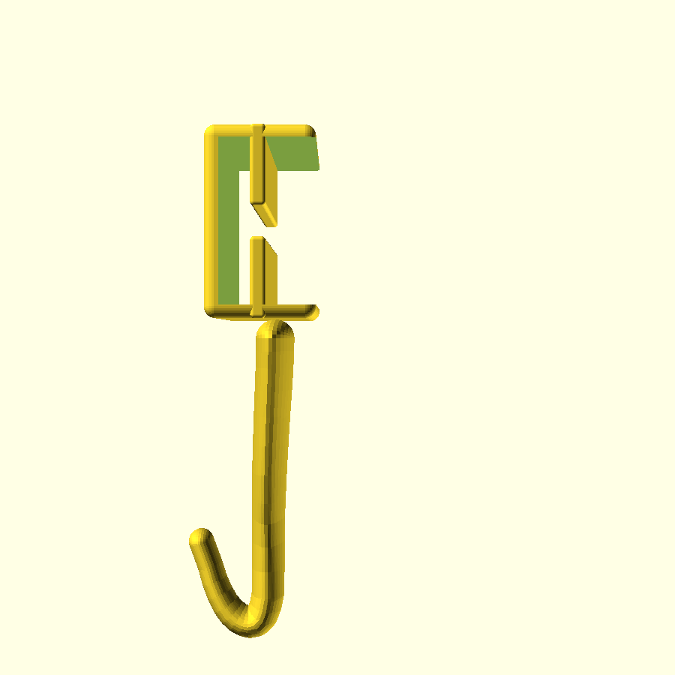
output/renders/history-hook-2026-10-17/candidates/fairing-candidate/hook-side.png
