Norman-w/SlidingRailHook/output/renders/history-hook-2026-10-17/candidates/hook-capture-section-candidate.png

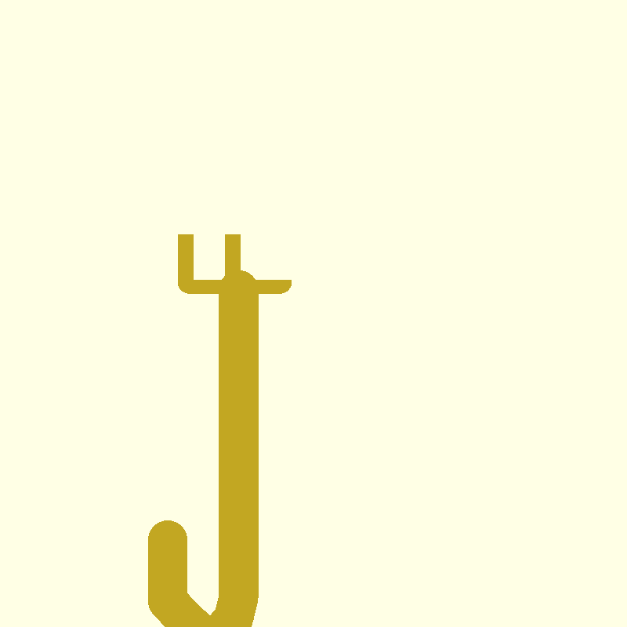
output/renders/history-hook-2026-10-17/candidates/hook-capture-section-candidate.png
