Norman-w/SlidingRailHook/output/renders/history-hook-2026-10-17/candidates/hook-iso.png

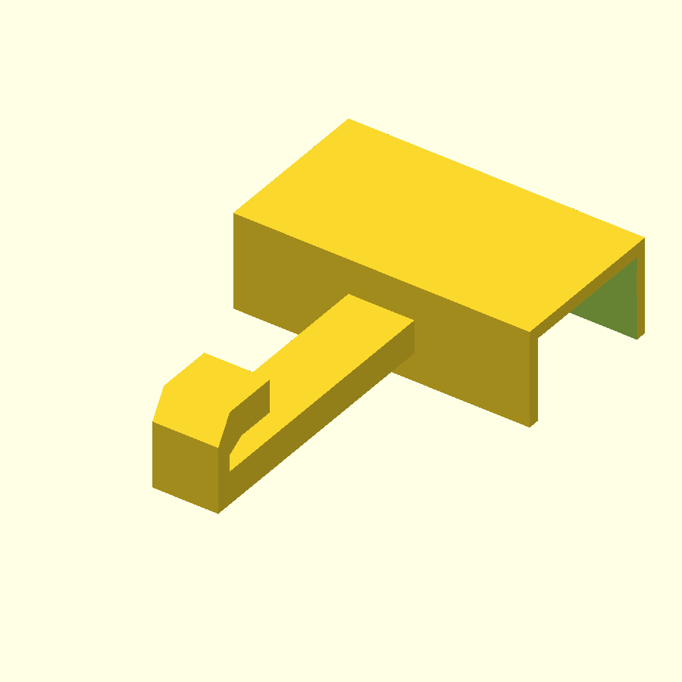
output/renders/history-hook-2026-10-17/candidates/hook-iso.png
