Norman-w/SlidingRailHook/output/renders/history-hook-2026-10-17/candidates/hook-side-profile.png

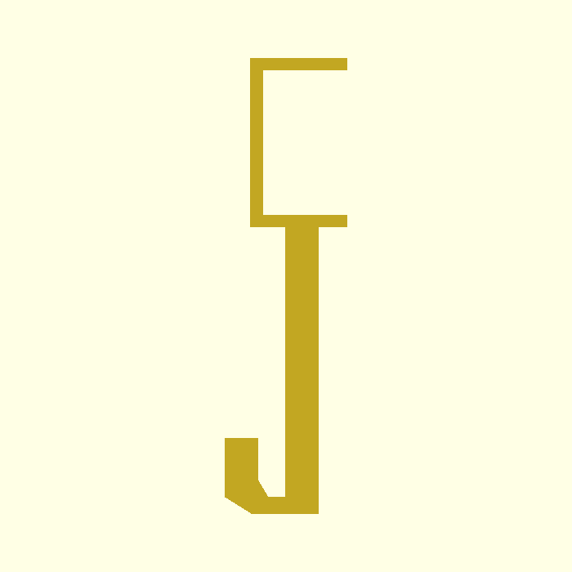
output/renders/history-hook-2026-10-17/candidates/hook-side-profile.png
