Norman-w/SlidingRailHook/output/renders/history-hook-2026-10-17/candidates/root-bridge-candidate-hook-root-closeup-solid.png

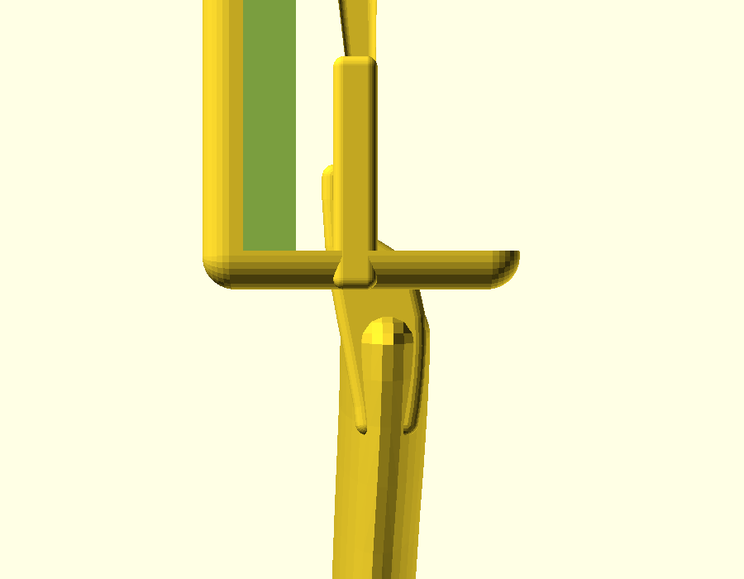
output/renders/history-hook-2026-10-17/candidates/root-bridge-candidate-hook-root-closeup-solid.png
