Norman-w/SlidingRailHook/output/renders/history-hook-2026-10-17/candidates/root-bridge-candidate-hook-root-closeup.png

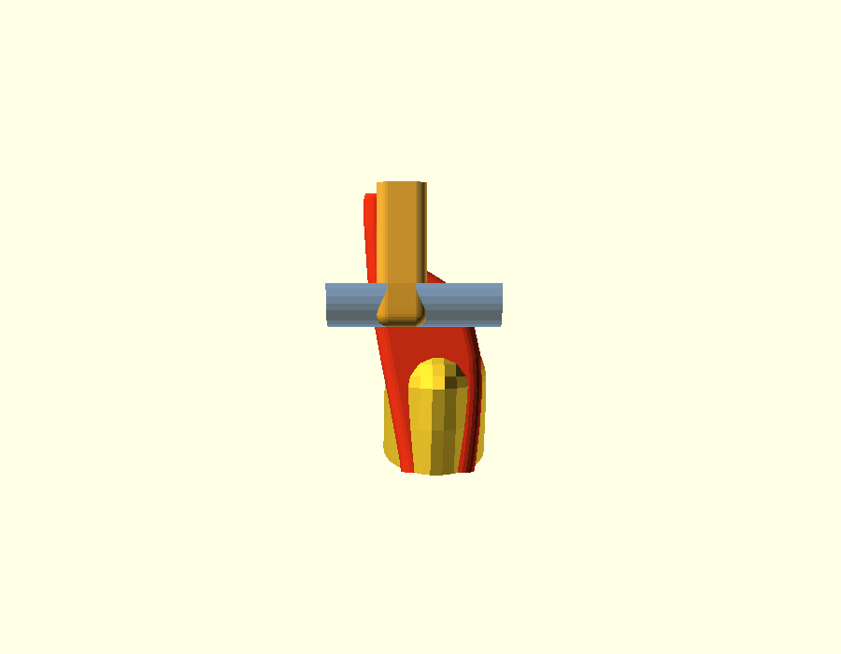
output/renders/history-hook-2026-10-17/candidates/root-bridge-candidate-hook-root-closeup.png
