Norman-w/SlidingRailHook/output/renders/history-hook-2026-10-17/candidates/root-bridge-candidate-section-zoom.png

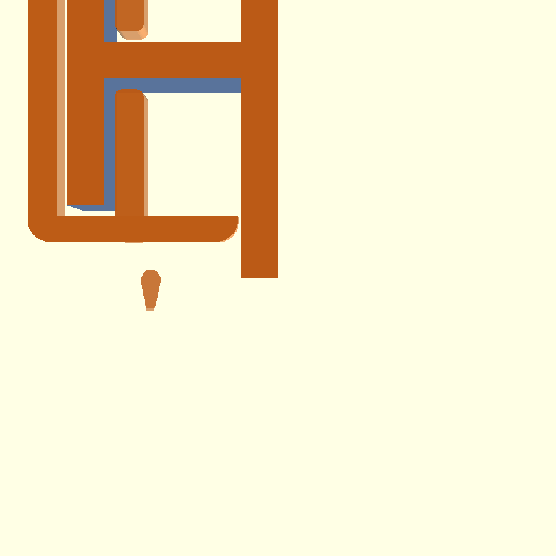
output/renders/history-hook-2026-10-17/candidates/root-bridge-candidate-section-zoom.png
