Norman-w/SlidingRailHook/output/renders/history-hook-2026-10-17/candidates/root-thick-candidate-hook-bridge-section.png

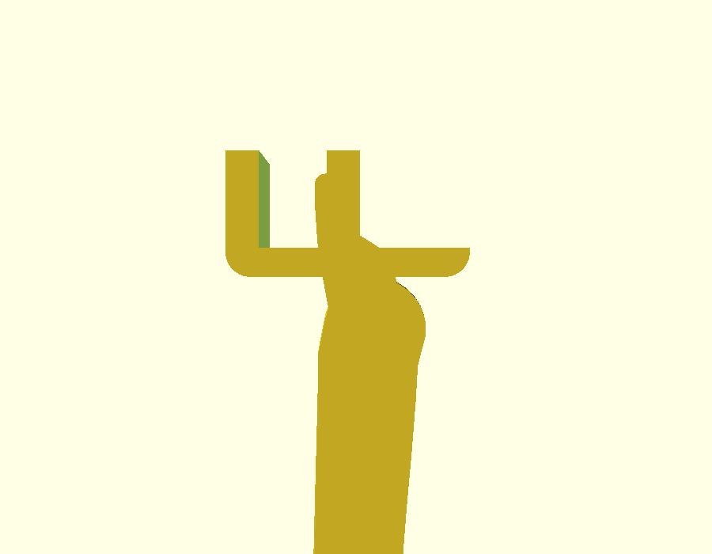
output/renders/history-hook-2026-10-17/candidates/root-thick-candidate-hook-bridge-section.png
