Norman-w/SlidingRailHook/output/renders/history-hook-2026-10-17/candidates/taper-candidate/hook-top.png

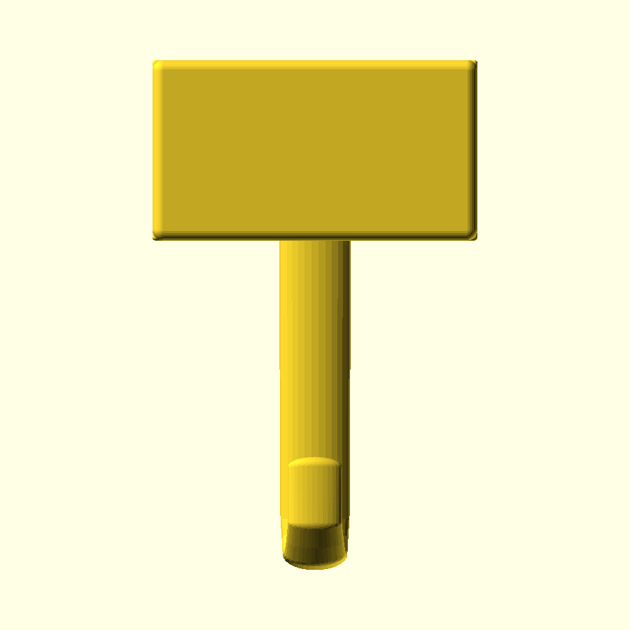
output/renders/history-hook-2026-10-17/candidates/taper-candidate/hook-top.png
