Norman-w/SlidingRailHook/output/renders/history-hook-bent-240deg-unrounded-2026-10-18/hook-bent-section.png

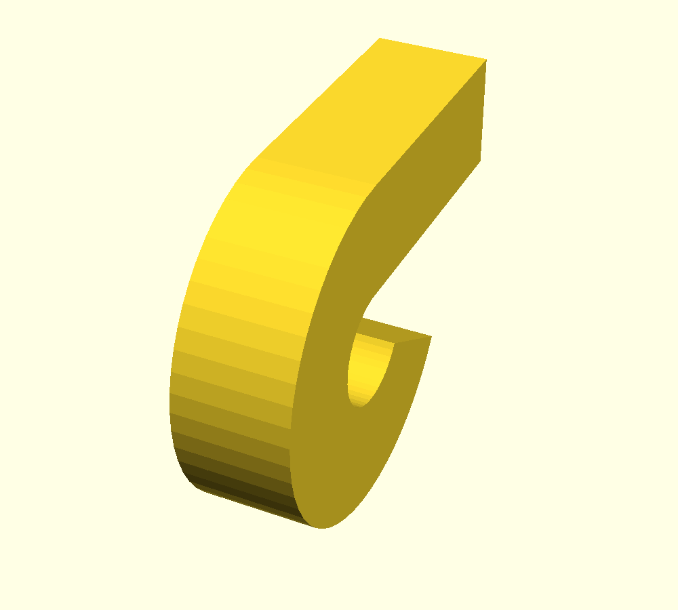
output/renders/history-hook-bent-240deg-unrounded-2026-10-18/hook-bent-section.png
