Norman-w/SlidingRailHook/output/renders/history-hook-trapezoid-flat-2026-10-18/hook-trapezoid-section.png

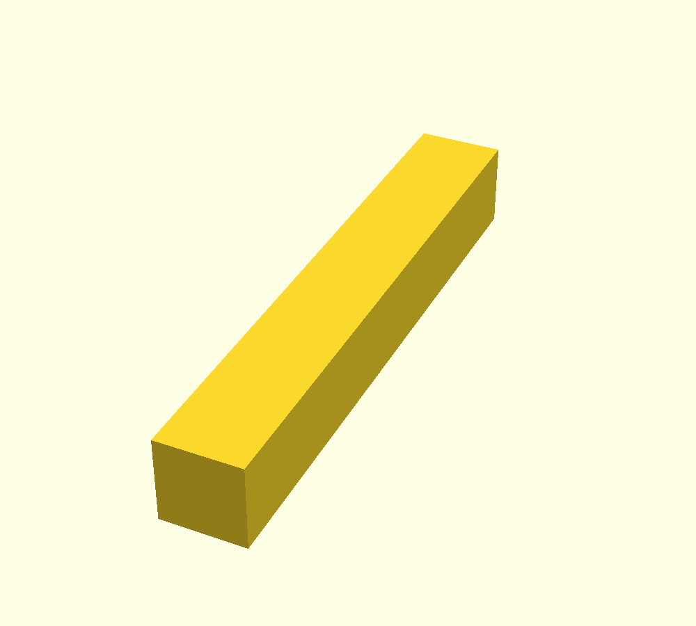
output/renders/history-hook-trapezoid-flat-2026-10-18/hook-trapezoid-section.png
