Norman-w/SlidingRailHook/(commit log)

2026-10-18 Add sliding rail hook with rounded R5 bend and concave root fillets
    [assembly.scad, end_stop.scad, end_stop_left.stl, end_stop_right.stl, hook-2d-bridge-pre-root-thicken-2026-10-17.stl, hook-anchor-pre-2d-bridge-2026-10-17.stl, hook-capture-pre-taper-2026-10-17.stl, hook-cgal.stl]
2026-10-18 🪝 补齐挂钩根部四角并准备公开 v0.1.0
    [corner_-1_-1.stl, corner_-1_1.stl, corner_1_-1.stl, corner_1_1.stl, end_stop_left.stl, end_stop_right.stl, face_-1.stl, face_1.stl]
2026-10-18 Add validated 12-hook PETG X1C print project
    [hook-12-PETG-X1C-0p4-0p12.3mf, hook-12-arranged.3mf, machine.json, slider_hook.stl]
2026-10-20 Correct measured H-rail fit and add support-free upright legacy rail STLs
    [corner_-1_-1.stl, corner_-1_1.stl, corner_1_-1.stl, corner_1_1.stl, end_stop_left.stl, end_stop_right.stl, face_-1.stl, face_1.stl]
